RSA-PPP/ppp-2024-02-shm-pcb-altium/altium/concentrador/PCB1.step

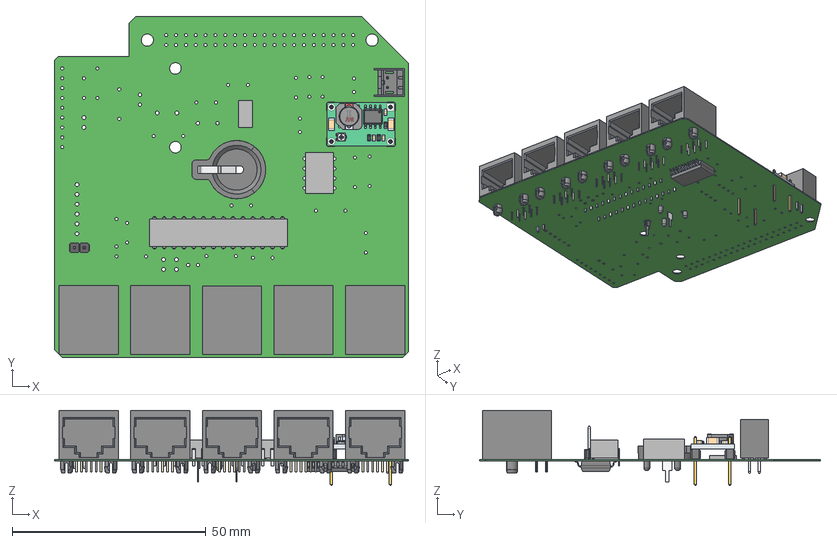
[picture p19: CAD file, 2026-11-05]
altium/concentrador/PCB1.step
91.4 x 88.0 x 19.4 mm
Board
hdr-1x2t_2.54_sh7x8
User_Library-PVZ2A_PVZ2A003
User_Library-PVZ2A_Fillet001
User_Library-so8-3
SW3DPS-CAPACITOR_0603-DEFAULT x 3
User_Library-R_SMD_0603_0603_BODY x 3
User_Library-R_SMD_0603_0603_PAD x 6
User_Library-R_SMD_0603_0603_OPIS x 3
EF8E81B4-BFF1-4722-89B6-6247B6CB4AD1 x 2
SW3DPS-HEADER_2_54_VERTICAL_2X-DEFAULT
Extruded x 87
21-0042B_20-M
rj45 x 5
