RSA-PPP/ppp-2024-02-shm-pcb-altium/altium/nodo/Librerias/acs714/STEP/SOIC-8.step

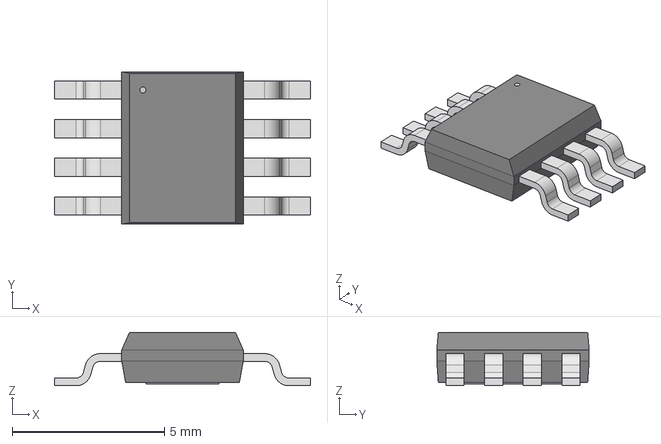
[picture p20: CAD file, 2026-11-05]
altium/nodo/Librerias/acs714/STEP/SOIC-8.step
8.40 x 5.00 x 1.75 mm
