RSA-PPP/ppp-2024-02-shm-pcb-altium/altium/nodo/Librerias/DS3231STR/STL/21-0042B_16.stp

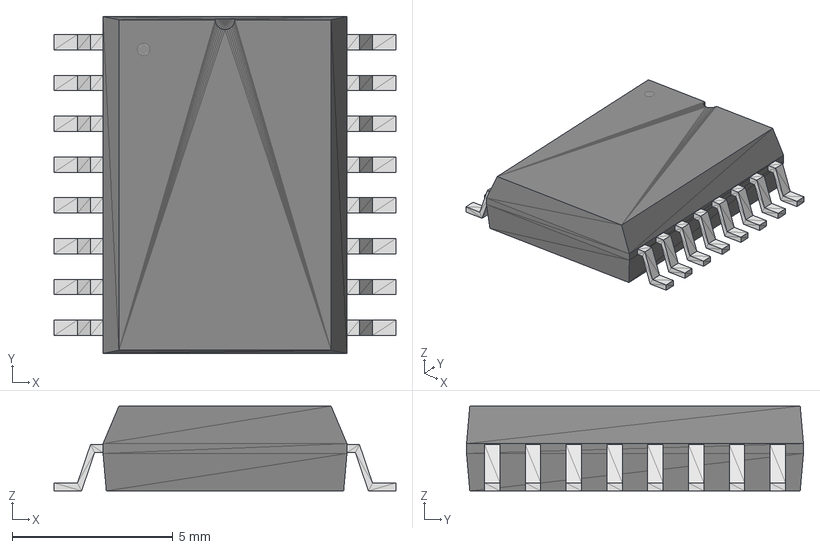
[picture p21: CAD file, 2026-11-05]
altium/nodo/Librerias/DS3231STR/STL/21-0042B_16.stp
10.6 x 10.5 x 2.64 mm
