RSA-PPP/ppp-2024-02-shm-pcb-altium/altium/nodo/Librerias/DS3234S/STEP/21-0042B_20-M.step

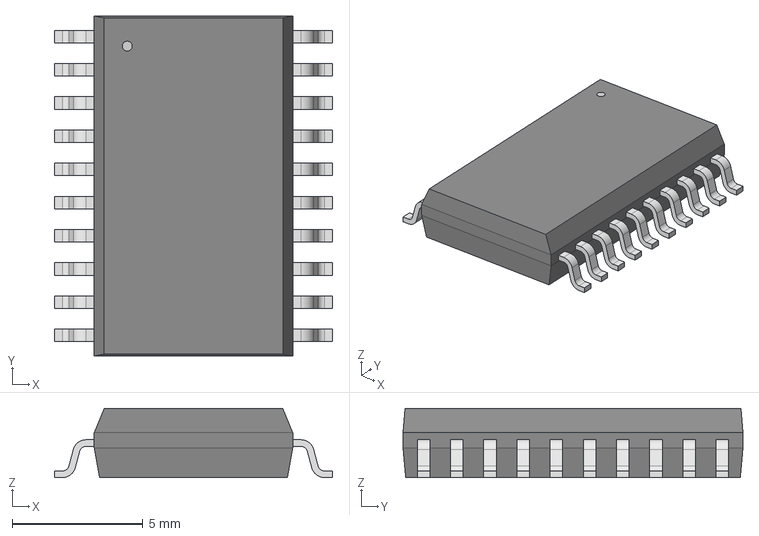
[picture p22: CAD file, 2026-11-05]
altium/nodo/Librerias/DS3234S/STEP/21-0042B_20-M.step
10.6 x 13.0 x 2.64 mm
