RSA-PPP/ppp-2024-02-shm-pcb-altium/altium/nodo/Librerias/HEF4071BP/STEP/SOT27-1.step

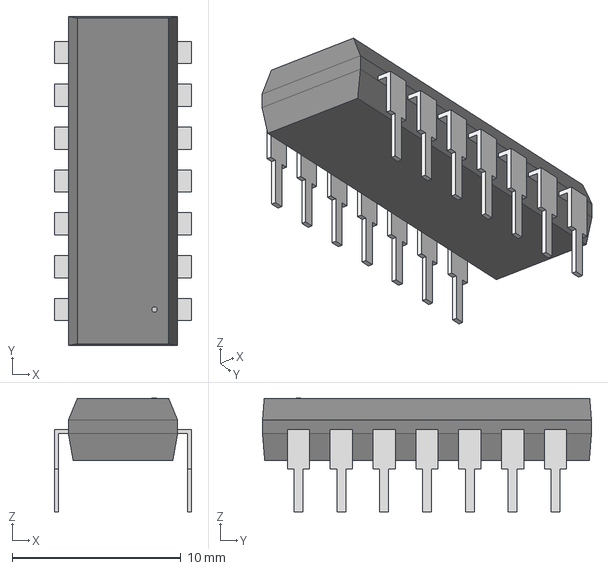
[picture p23: CAD file, 2026-11-05]
altium/nodo/Librerias/HEF4071BP/STEP/SOT27-1.step
8.13 x 19.5 x 6.73 mm
