RSA-PPP/ppp-2024-02-shm-pcb-altium/altium/nodo/Librerias/digiKey/LM1117DT_5_0_NOPB/LM1117DT-5.0_NOPB.step

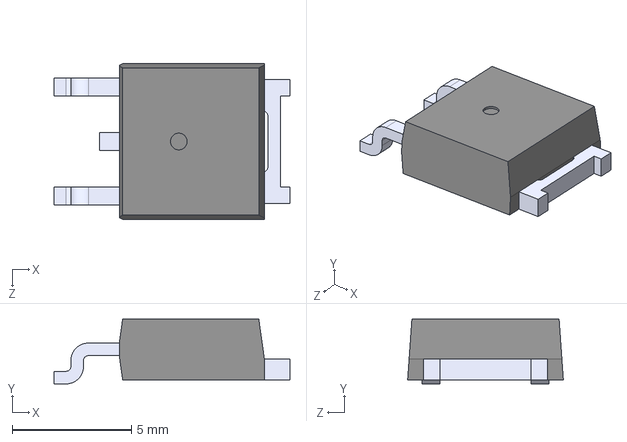
[picture p24: CAD file, 2026-11-05]
altium/nodo/Librerias/digiKey/LM1117DT_5_0_NOPB/LM1117DT-5.0_NOPB.step
9.91 x 2.72 x 6.54 mm
