RSA-PPP/ppp-2024-02-shm-pcb-altium/(list of files, cad)

Other CAD files:
altium/nodo/cortes acrilico 5MM.dwg
docs/hardware/cortes acrilico 5MM.dwg
altium/nodo/Librerias/DS3231STR/STL/21-0042B_16-L.stp
altium/nodo/Librerias/DS3234S/STEP/21-0042B_20-L.step
altium/nodo/PCB.DWG
docs/hardware/PCB.DWG
altium/nodo/Librerias/DS3231STR/STL/21-0042B_16-M.stp
altium/nodo/Librerias/DS3234S/STEP/21-0042B_20.step
altium/nodo/Librerias/DS3231STR/STL/21-0042B_16-L.stl
altium/nodo/Librerias/DS3231STR/STL/21-0042B_16-M.stl
altium/nodo/Librerias/DS3231STR/STL/21-0042B_16.stl
