RSA-PPP/ppp-2024-02-shm-pcb-altium/altium/concentrador/Sheet1.pdf

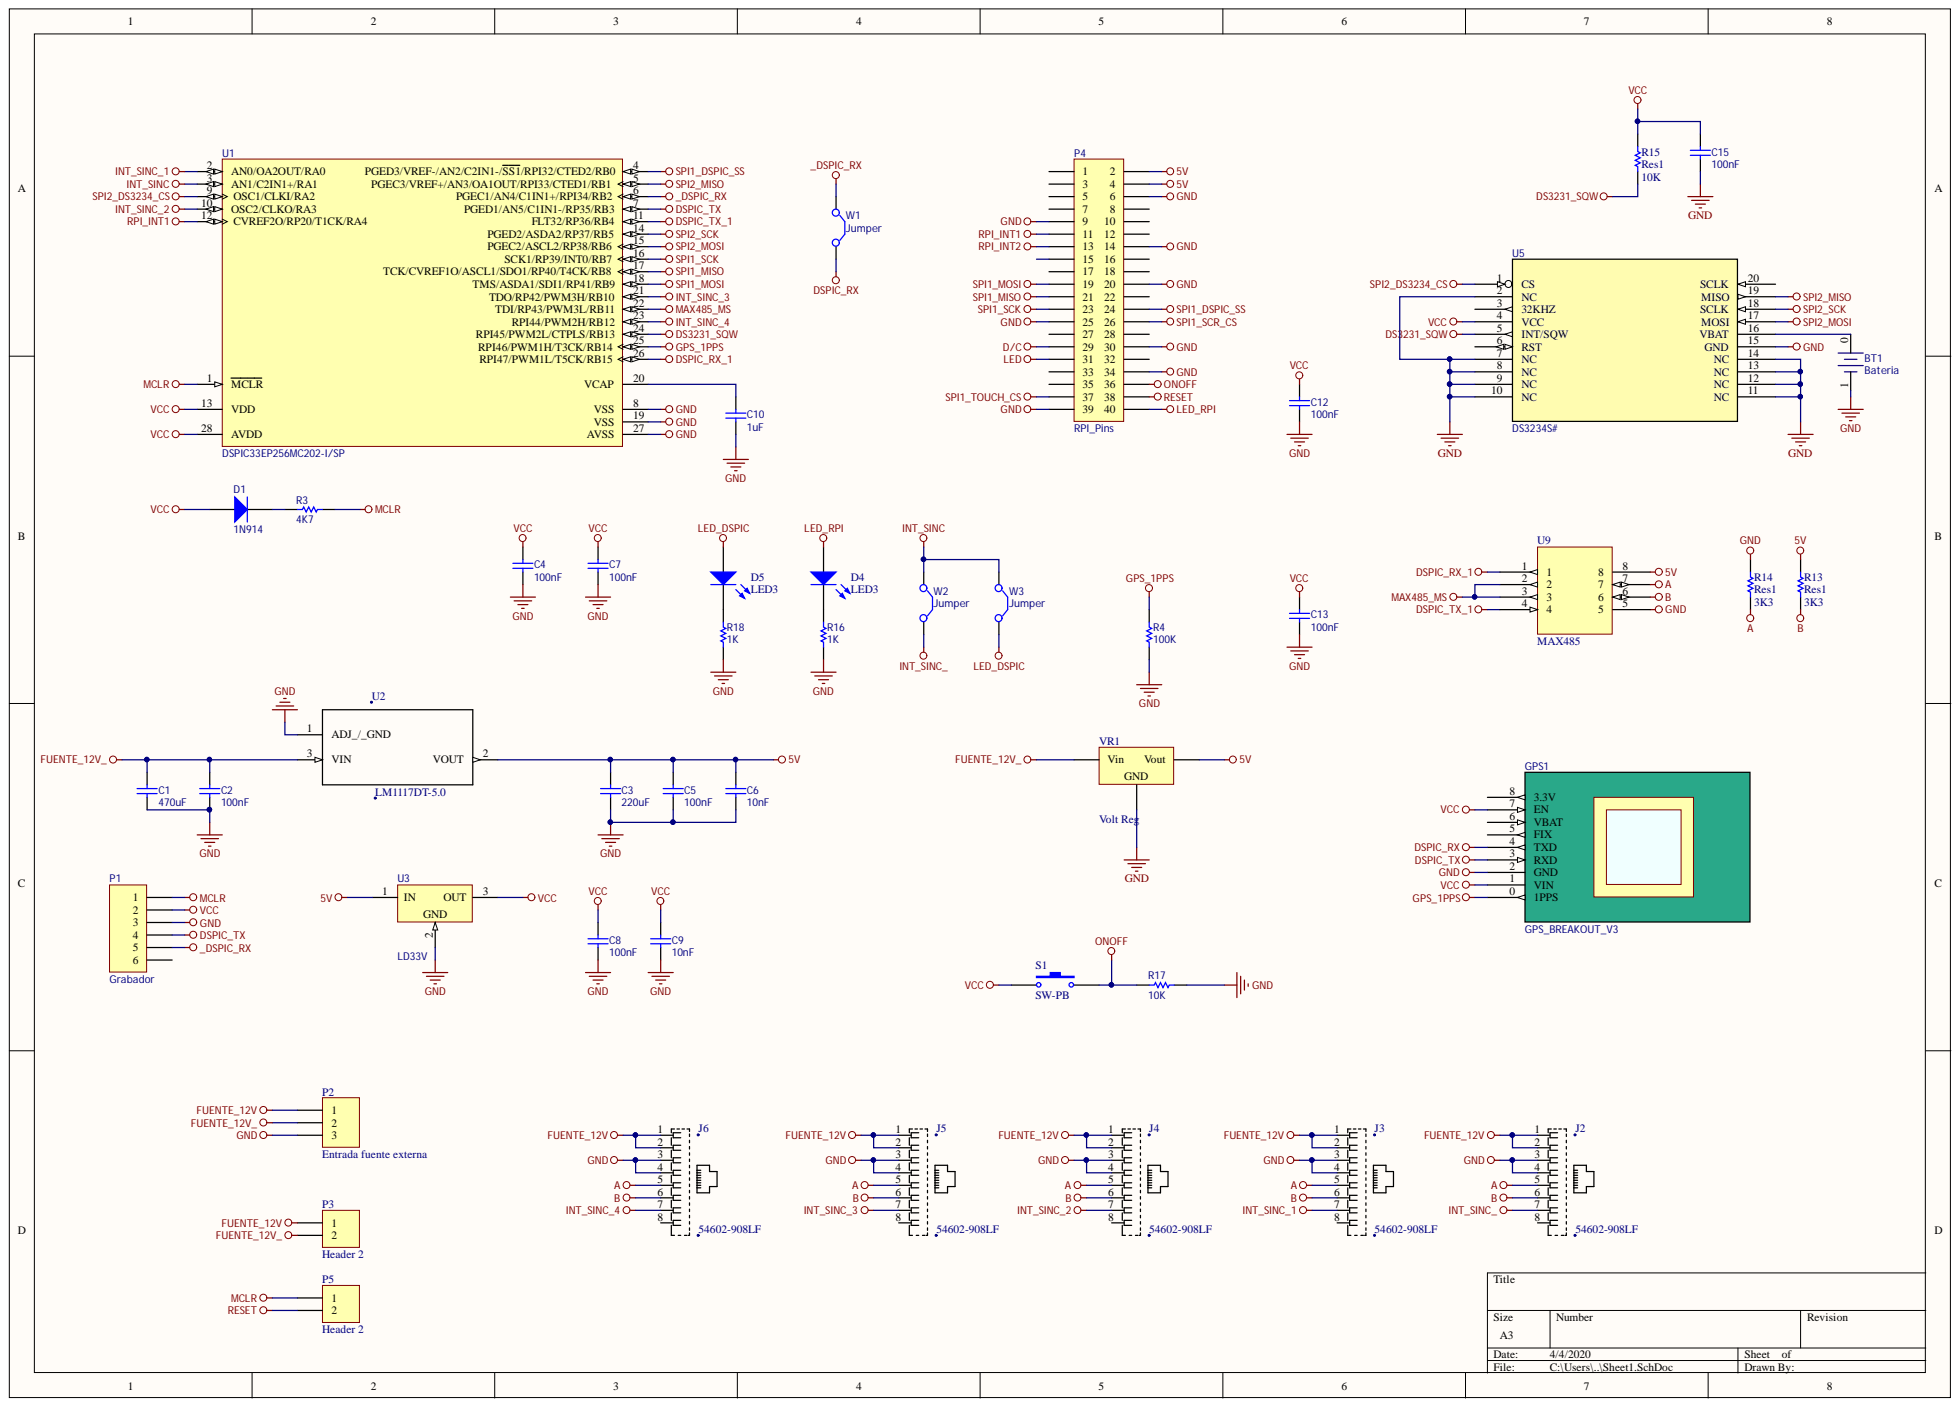
[picture p25: page 1]

Comment | Description | Designator | Footprint | LibRef | Quantity
Bateria | | BT1 | Bateria-DS1307 | BateriaDS1307 | 1
Cap | Capacitor | C1, C3 | C100UFB | Cap | 2
Cap | Capacitor | C2, C4, C5, C6, C7, C8, C9, C10, C12, C13, C15 | RAD0.2 | Cap | 11
1N914 | High Conductance Fast Diode | D1 | DO-35 | Diode 1N914 | 1
LED3 | Typical BLUE SiC LED | D4, D5 | LED2 | LED3 | 2
GPS_BREAKOUT_V3 | | GPS1 | GPS_BREAKOUT_V3 | GPS_BREAKOUT_V3 | 1
54602-908LF | Jack Modular Connector 8p8c _RJ45, Ethernet_ 90Â° Angle _Right_ Unshielded Cat3 | J2, J3, J4, J5, J6 | *AMPHENOL_54602-908LF | 54602-908LF | 5
Grabador | Header, 6-Pin | P1 | HDR1X6 | Header 6 | 1
Entrada fuente externa | Header, 3-Pin | P2 | MOLEX-3 | Header 3 | 1
Header 2 | Header, 2-Pin | P3, P5 | Header 1X2 | Header 2 | 2
RPI_Pins | Header, 20-Pin, Dual row | P4 | HDR2X20 | Header 20X2 | 1
Res1 | Resistor | R3, R4, R13, R14, R15, R16, R17, R18 | AXIAL-0.3 | Res1 | 8
SW-PB | Switch | S1 | PULSA4 | SW-PB | 1
DSPIC33EP256MC202-I/SP | 16-Bit Microcontroller and Digital Signal Controller with High-Speed PWM, Op Amps and Advanced Analog, 70 MIPS, 21 I/O, GPIO, -40 to 85 degC, 28-pin SPDIP (SP28), Tube | U1 | MCHP-SPDIP-SP28 | DSPIC33EP256MC202-I/SP | 1
LM1117DT-5.0 | Linear Voltage Regulator IC 1 Output 800mA TO-252-3 | U2 | *TO228P970X238-3N | LM1117DT-5.0 | 1
LD33V | High-Performance 16-bit Digital Signal Controller, 24 KB Flash, 2 KB SRAM, 1 KB EEPROM, 40-Pin PDIP, Industrial Temperature | U3 | SOT-223 | LD33V | 1
DS3234S# | No Description Available | U5 | 21-0042B_20 | DS3234S# | 1
MAX485 | | U9 | MAX485 | MAX485 | 1
Volt Reg | Voltage Regulator | VR1 | TO-220V | Volt Reg | 1
Jumper | Jumper Wire | W1, W2, W3 | SIP-2 | Jumper | 3
