RSA-PPP/ppp-2024-02-shm-pcb-altium/docs/hardware/acelerografo(NoDo).pdf

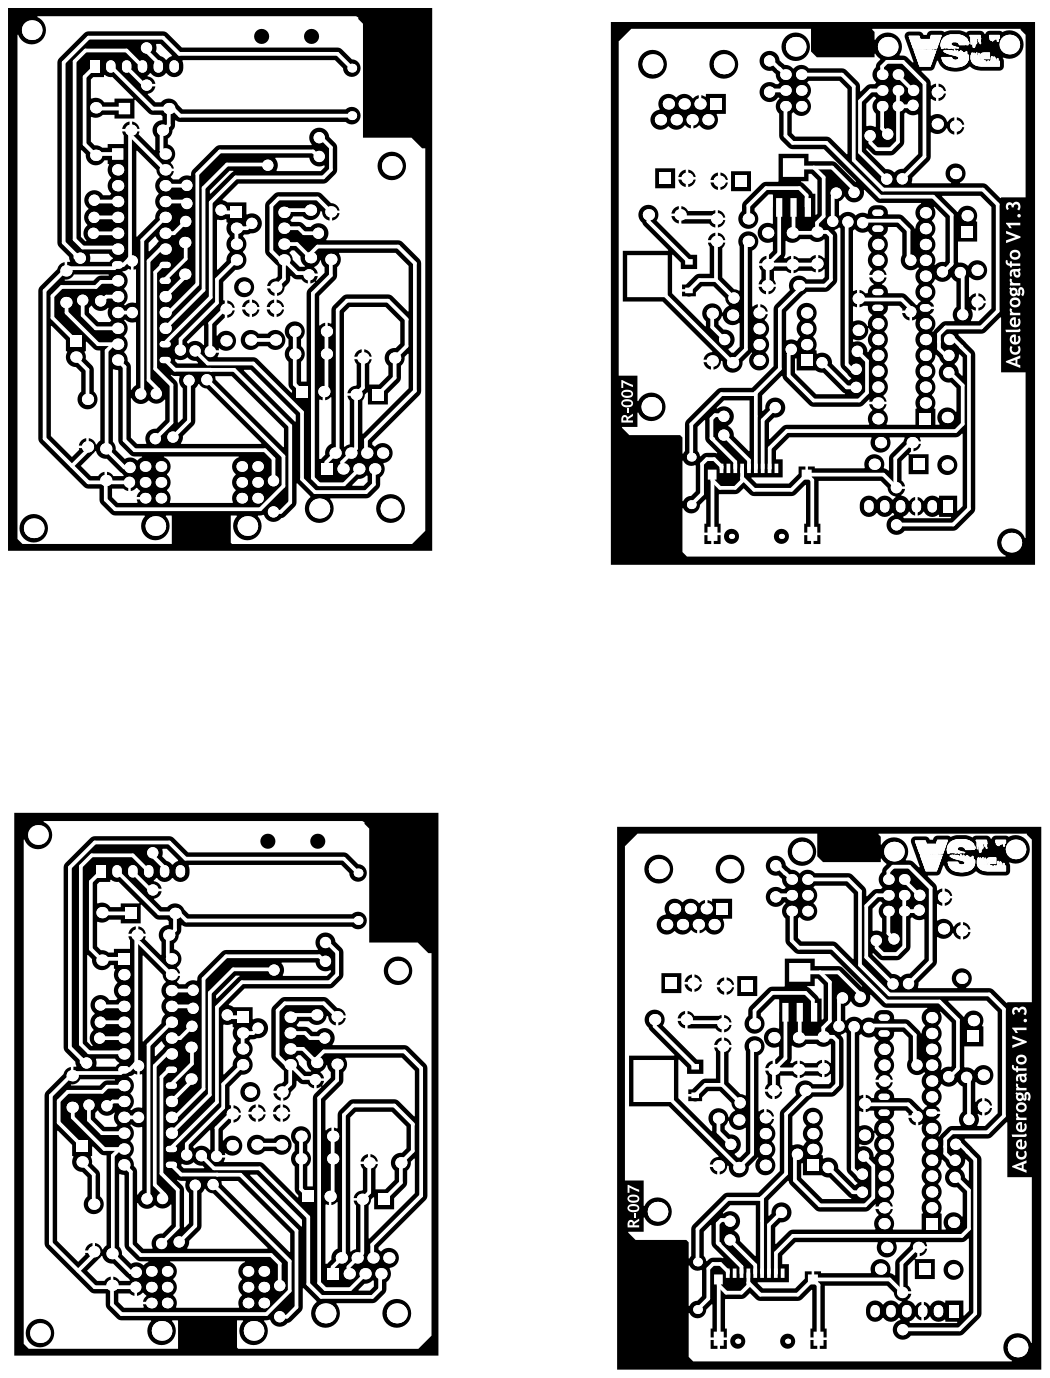
[picture p26: page 1]
