RSA-PPP/ppp-2024-02-shm-pcb-altium/docs/hardware/acelerometro_concetrador.pdf

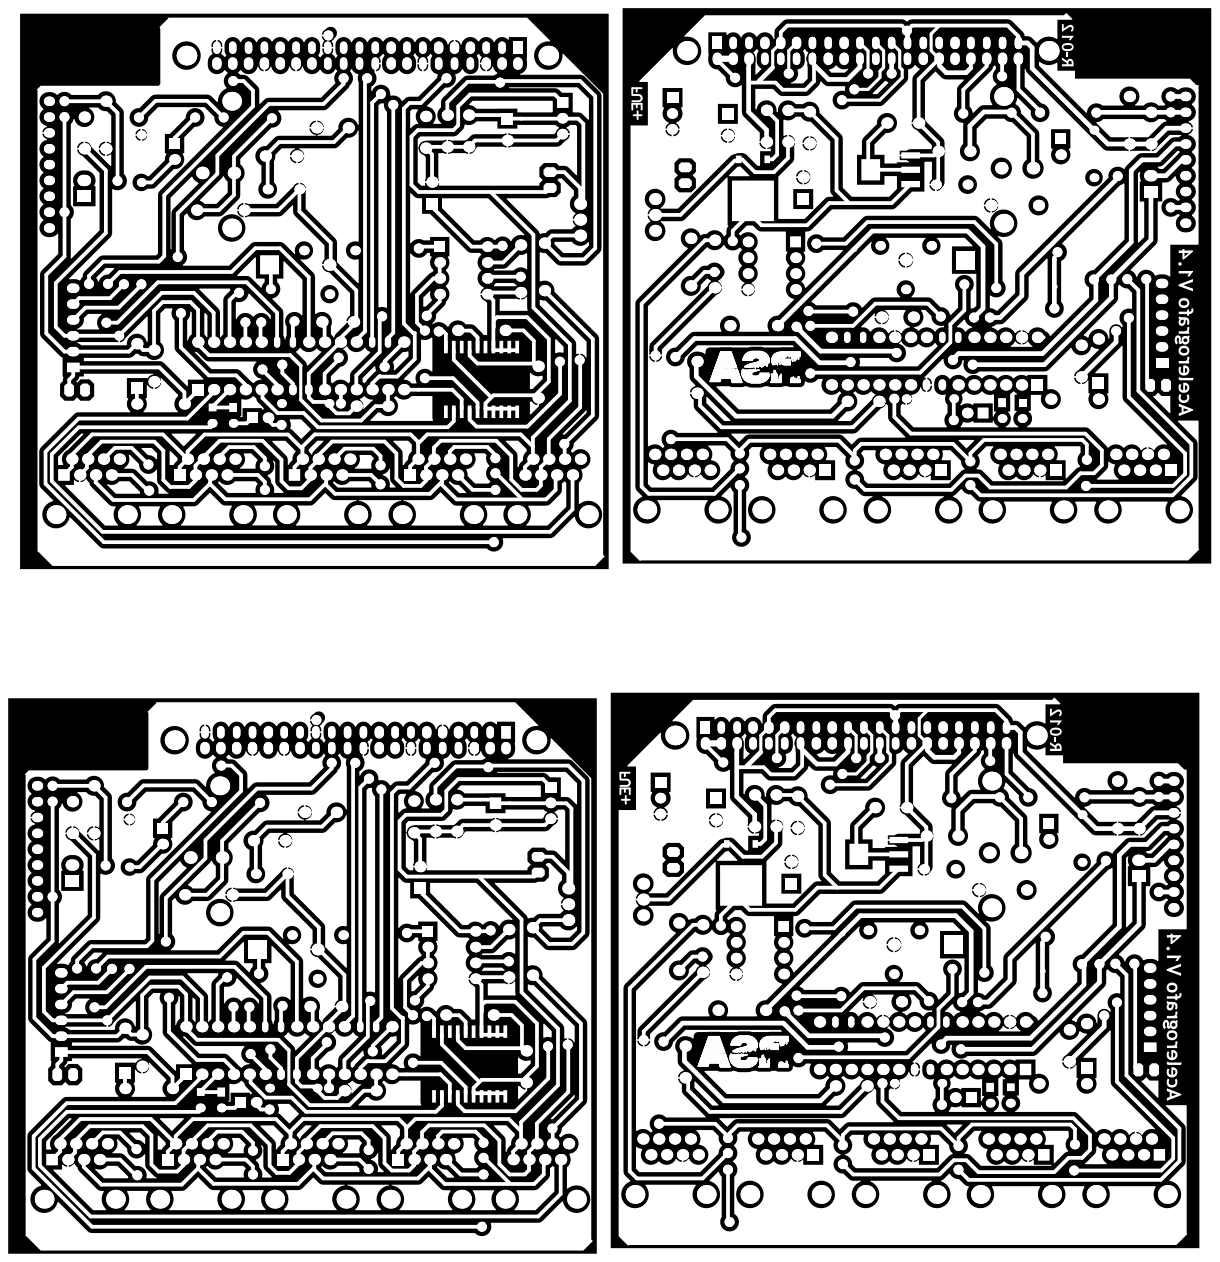
[picture p27: page 1]
