RSA-PPP/ppp-2024-02-shm-pcb-altium/docs/hardware/acelerometro_nodo.pdf

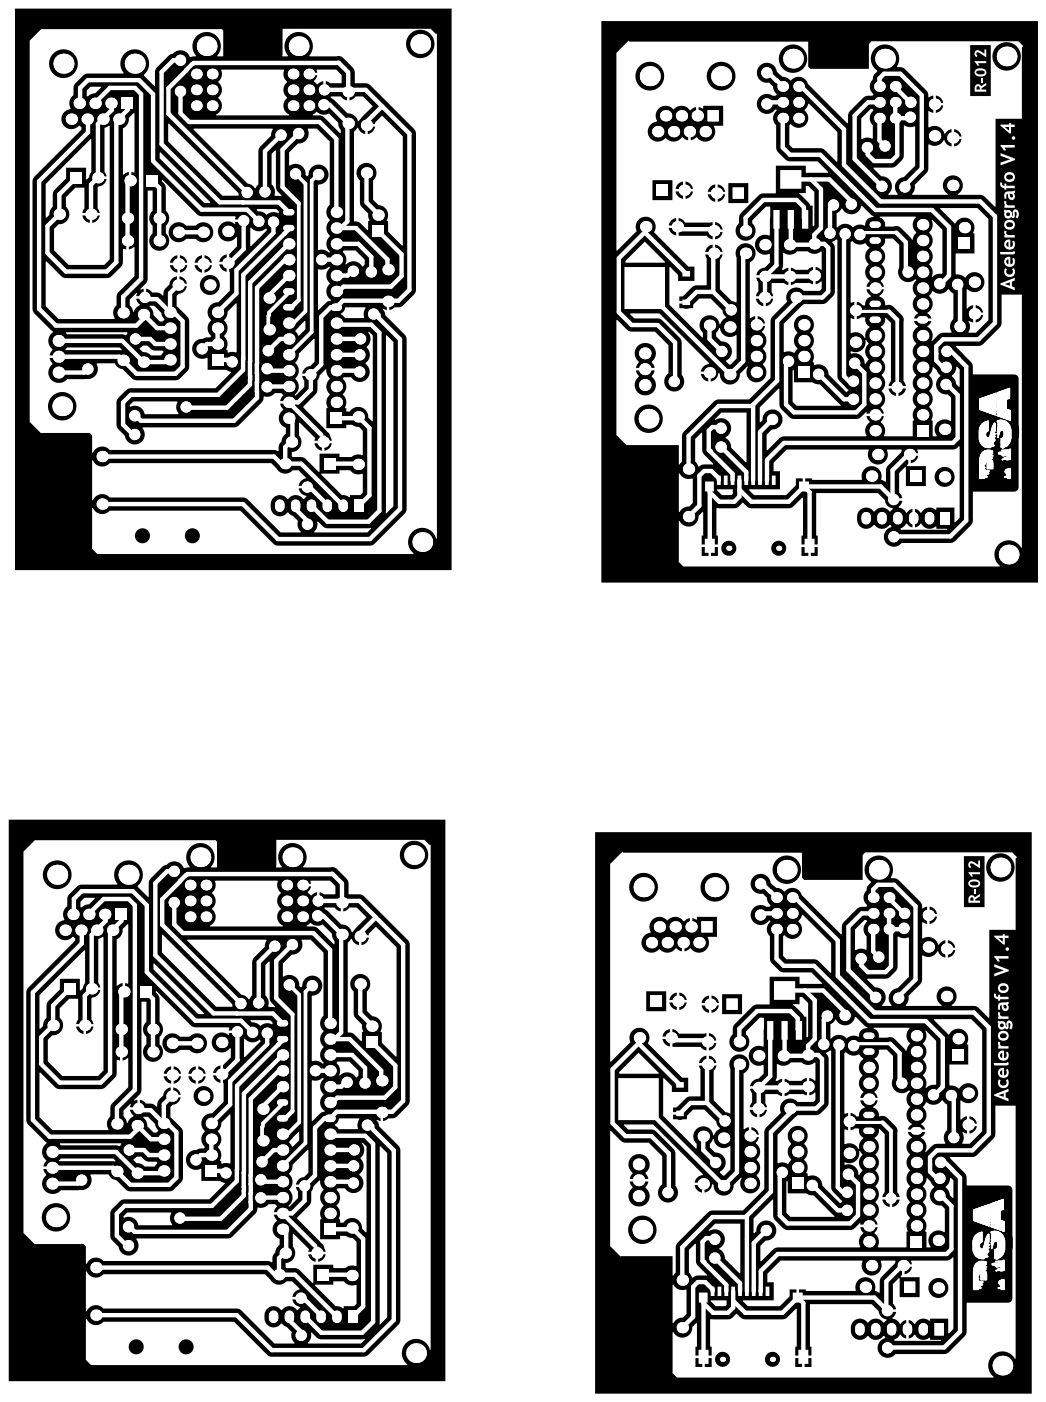
[picture p28: page 1]
