RSA-PPP/ppp-2024-02-shm-pcb-altium/docs/hardware/Esquematico_PCB_Concentrador.pdf

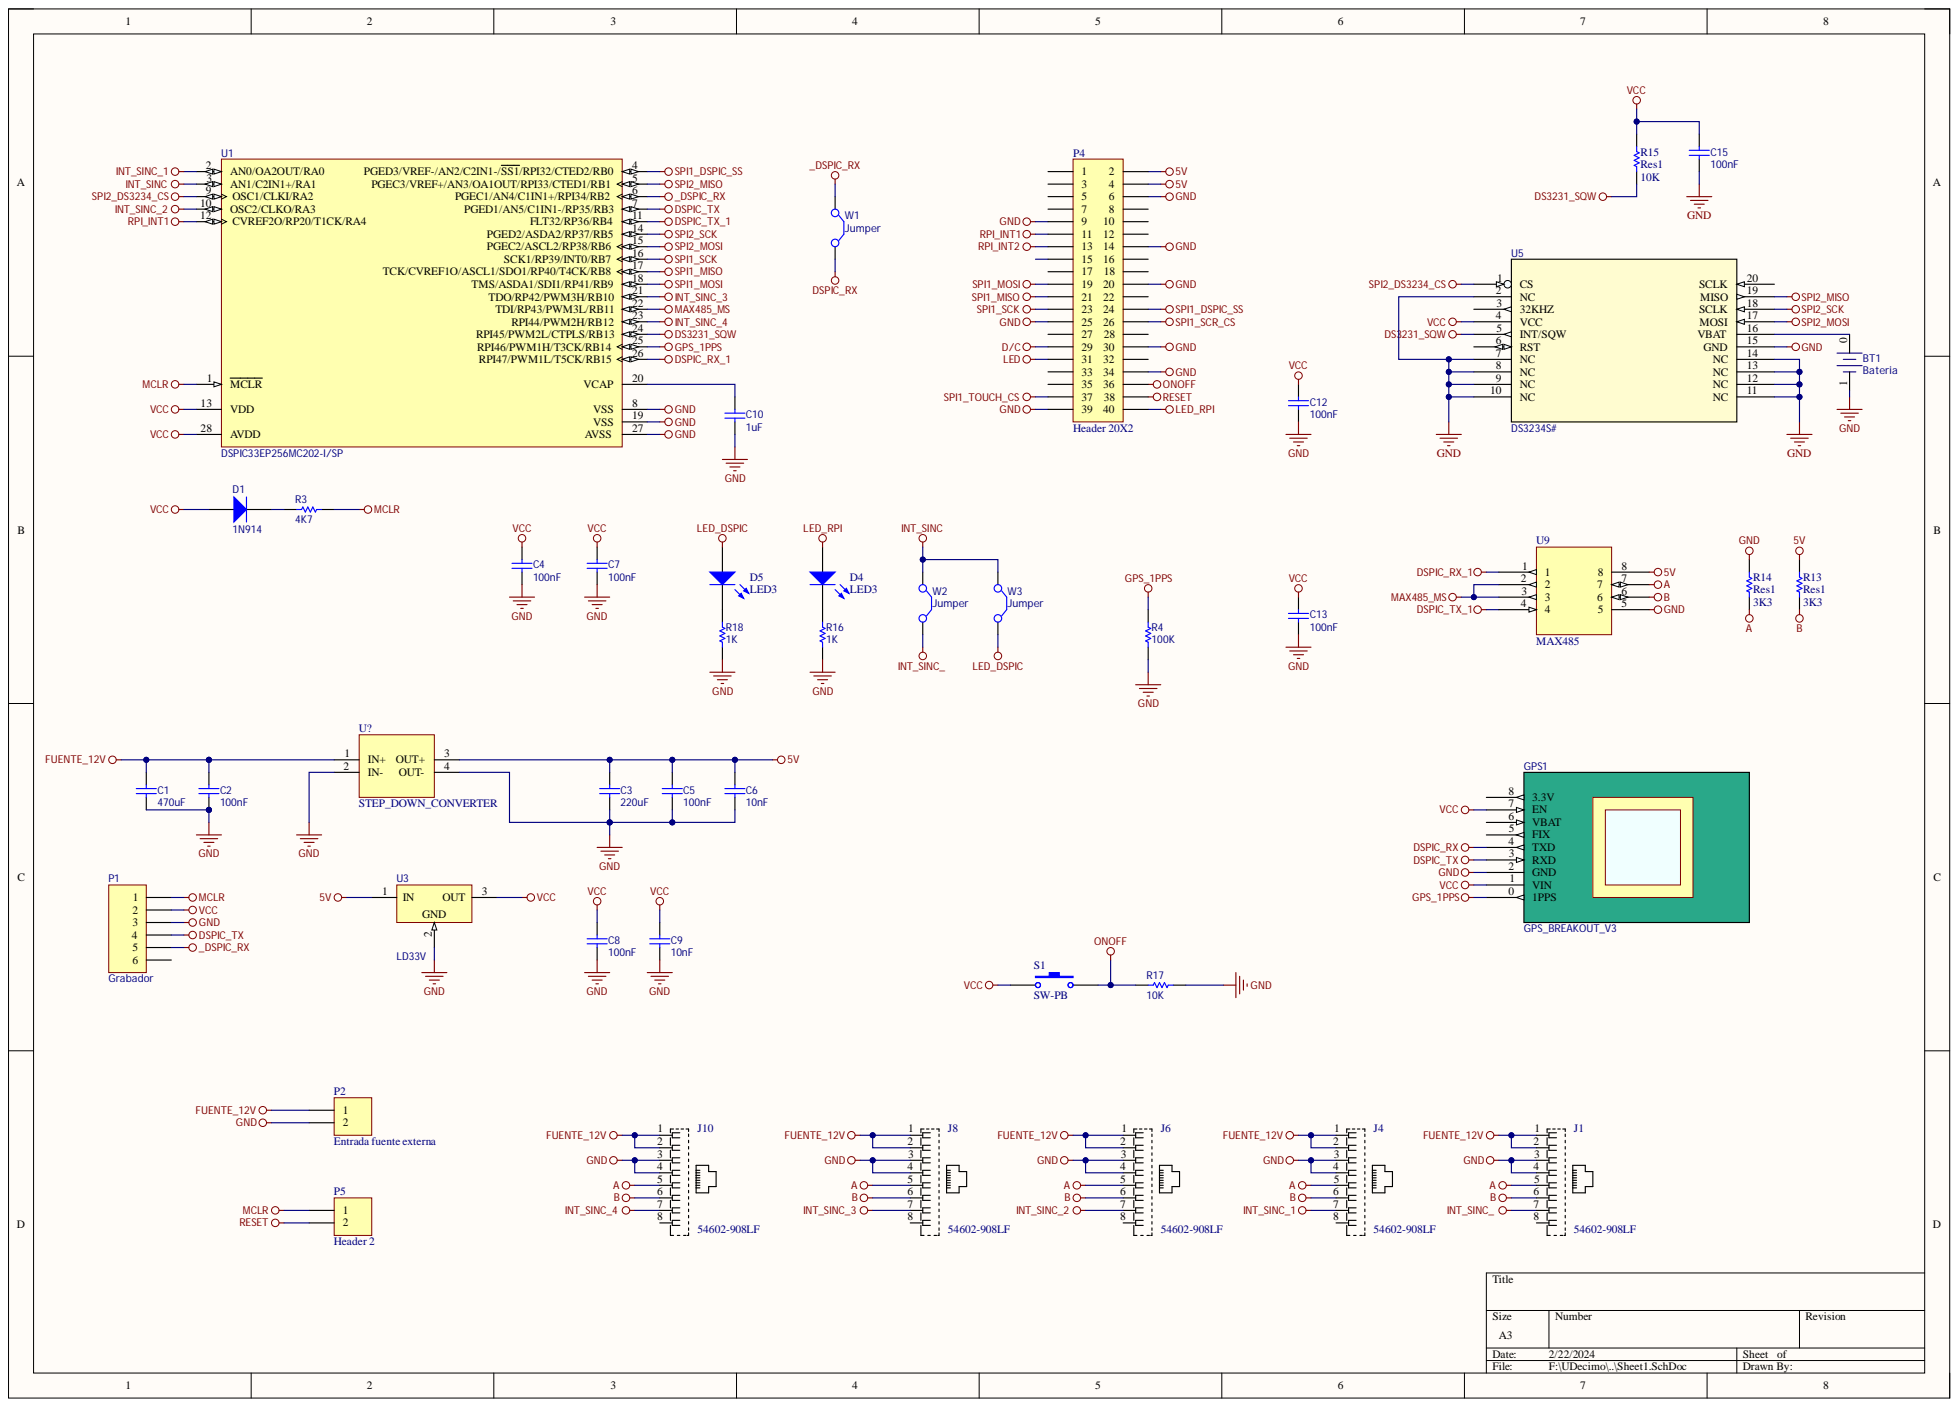
[picture p29: page 1]

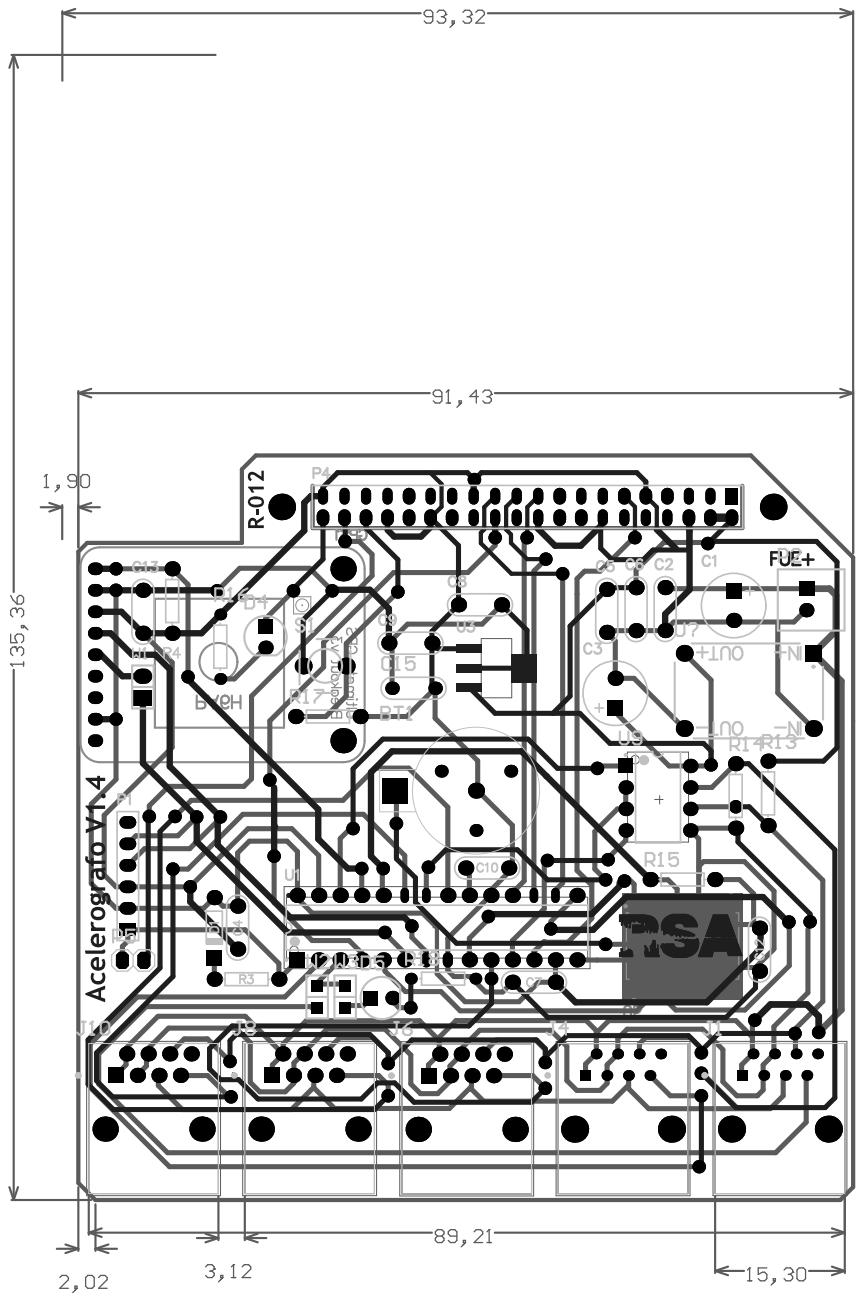
[picture p30: page 2]
