RSA-PPP/ppp-2024-02-shm-pcb-altium/docs/hardware/Fotolito.pdf

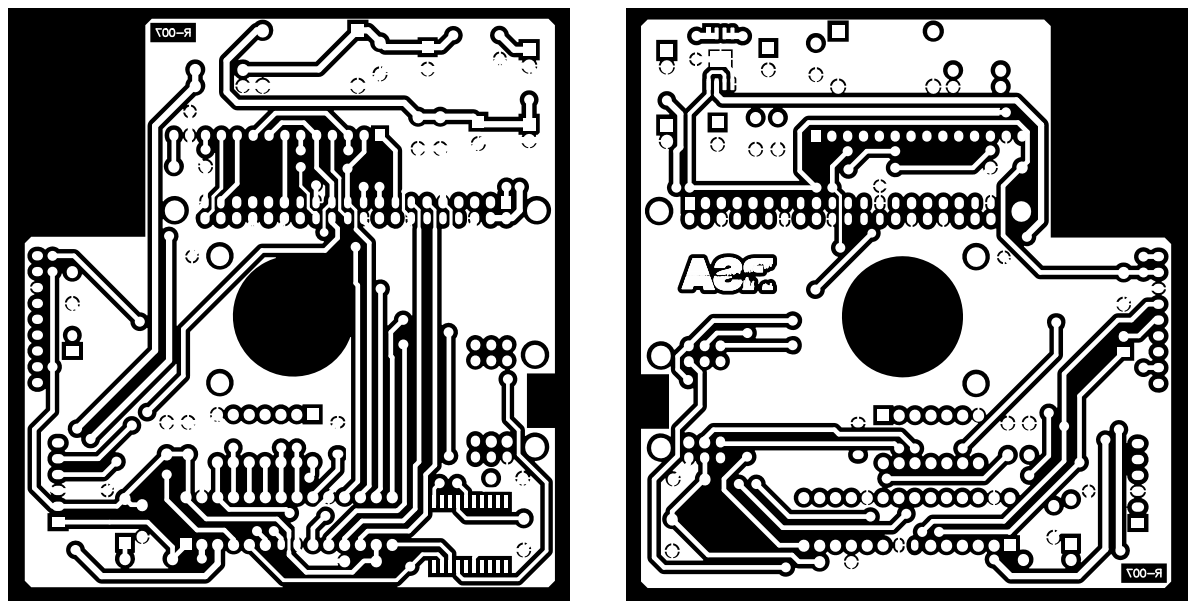
[picture p31: page 1]
