RSA-PPP/ppp-2024-02-shm-pcb-altium/docs/hardware/fotolitoBOTTOM.pdf

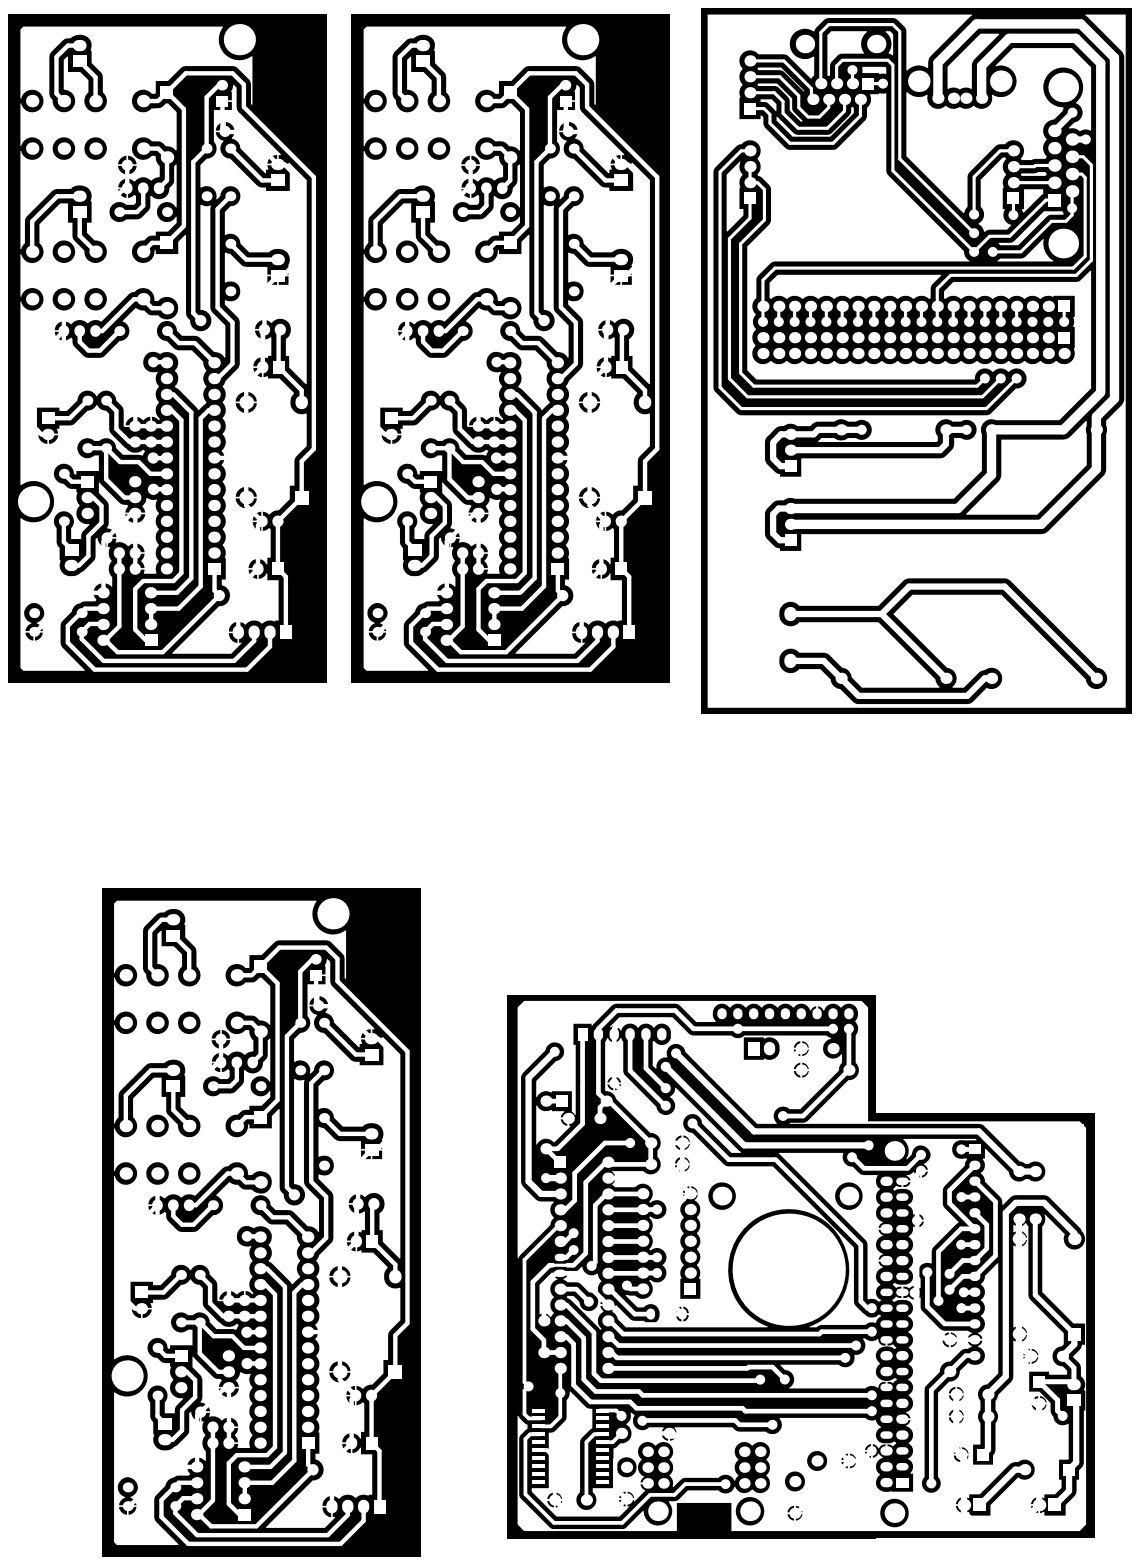
[picture p32: page 1]
