RSA-PPP/ppp-2024-02-shm-pcb-altium/docs/hardware/fotolitoTOP.pdf

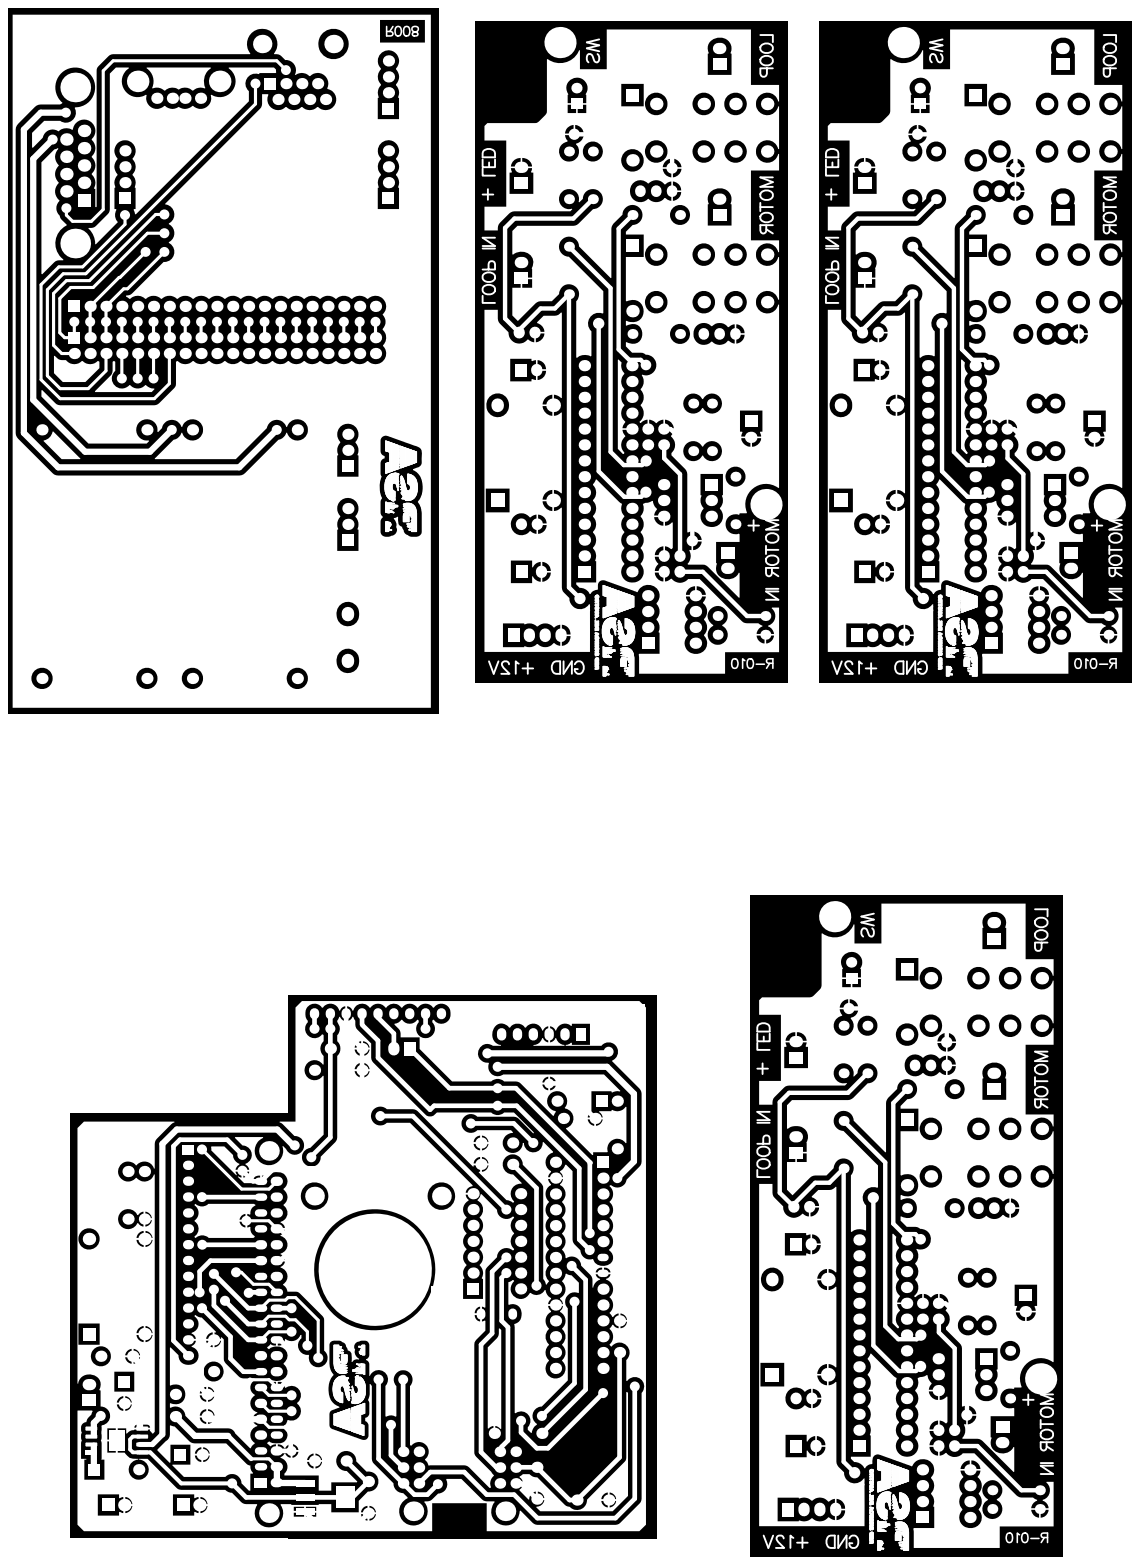
[picture p33: page 1]
