RSA-PPP/ppp-2024-02-shm-pcb-altium/docs/hardware/Job1_Concentrador.PDF

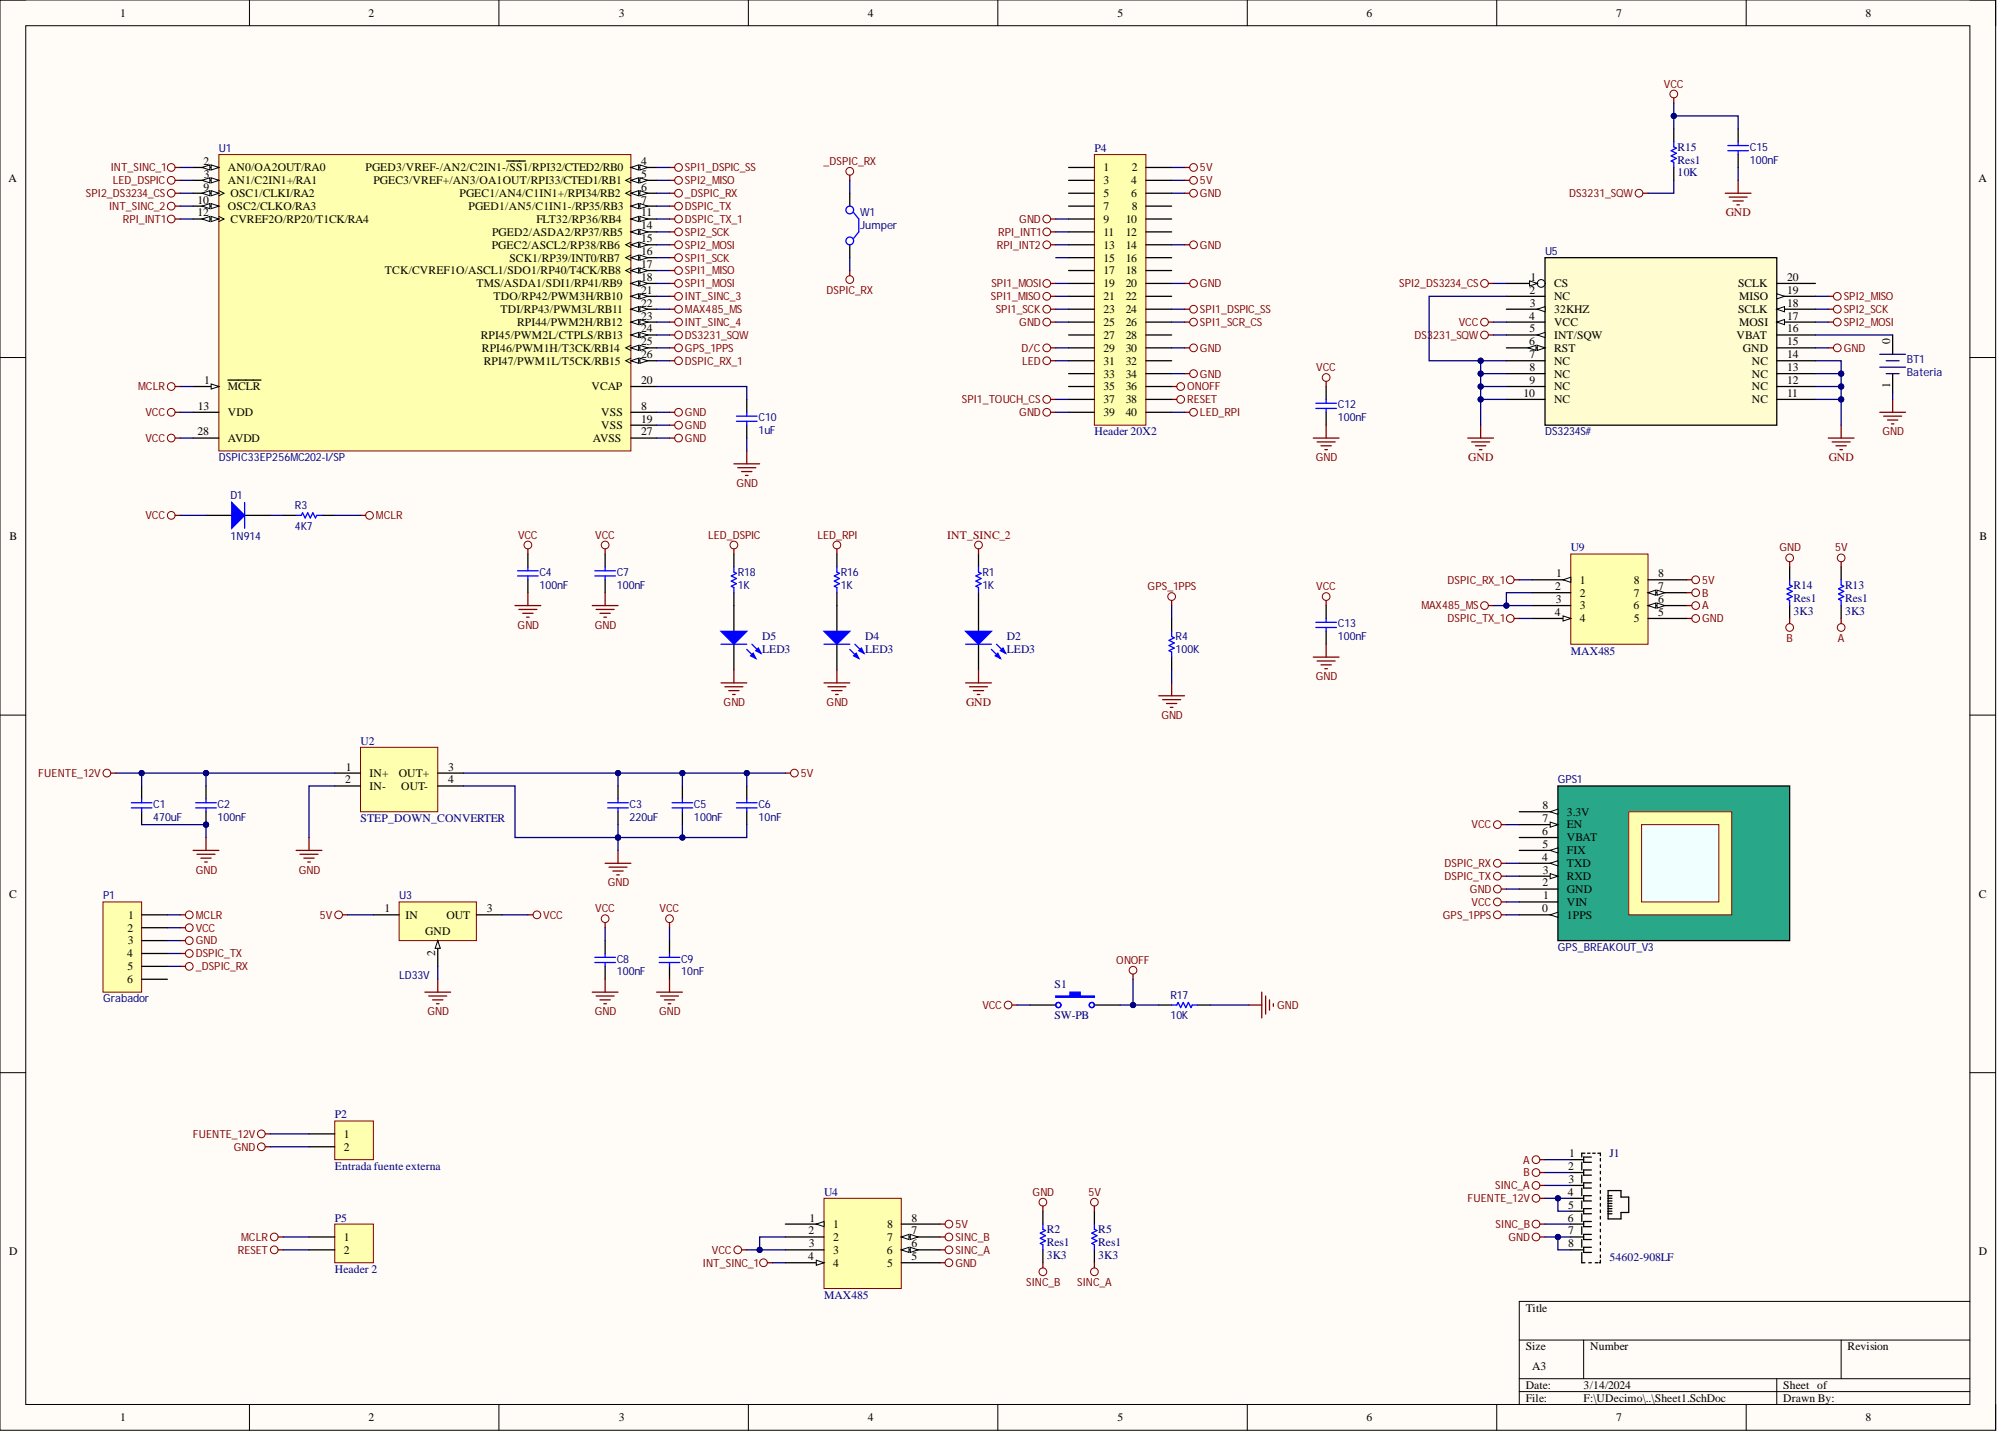
[picture p34: page 1]

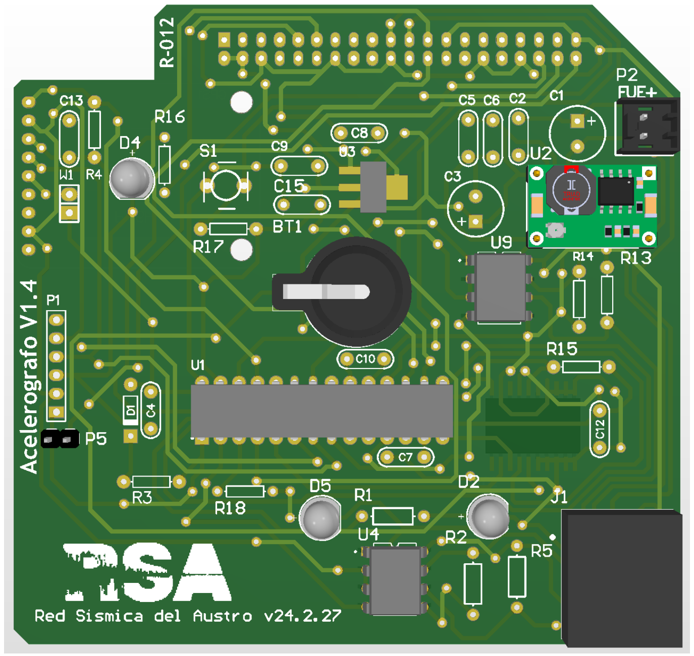
[picture p35: page 2]

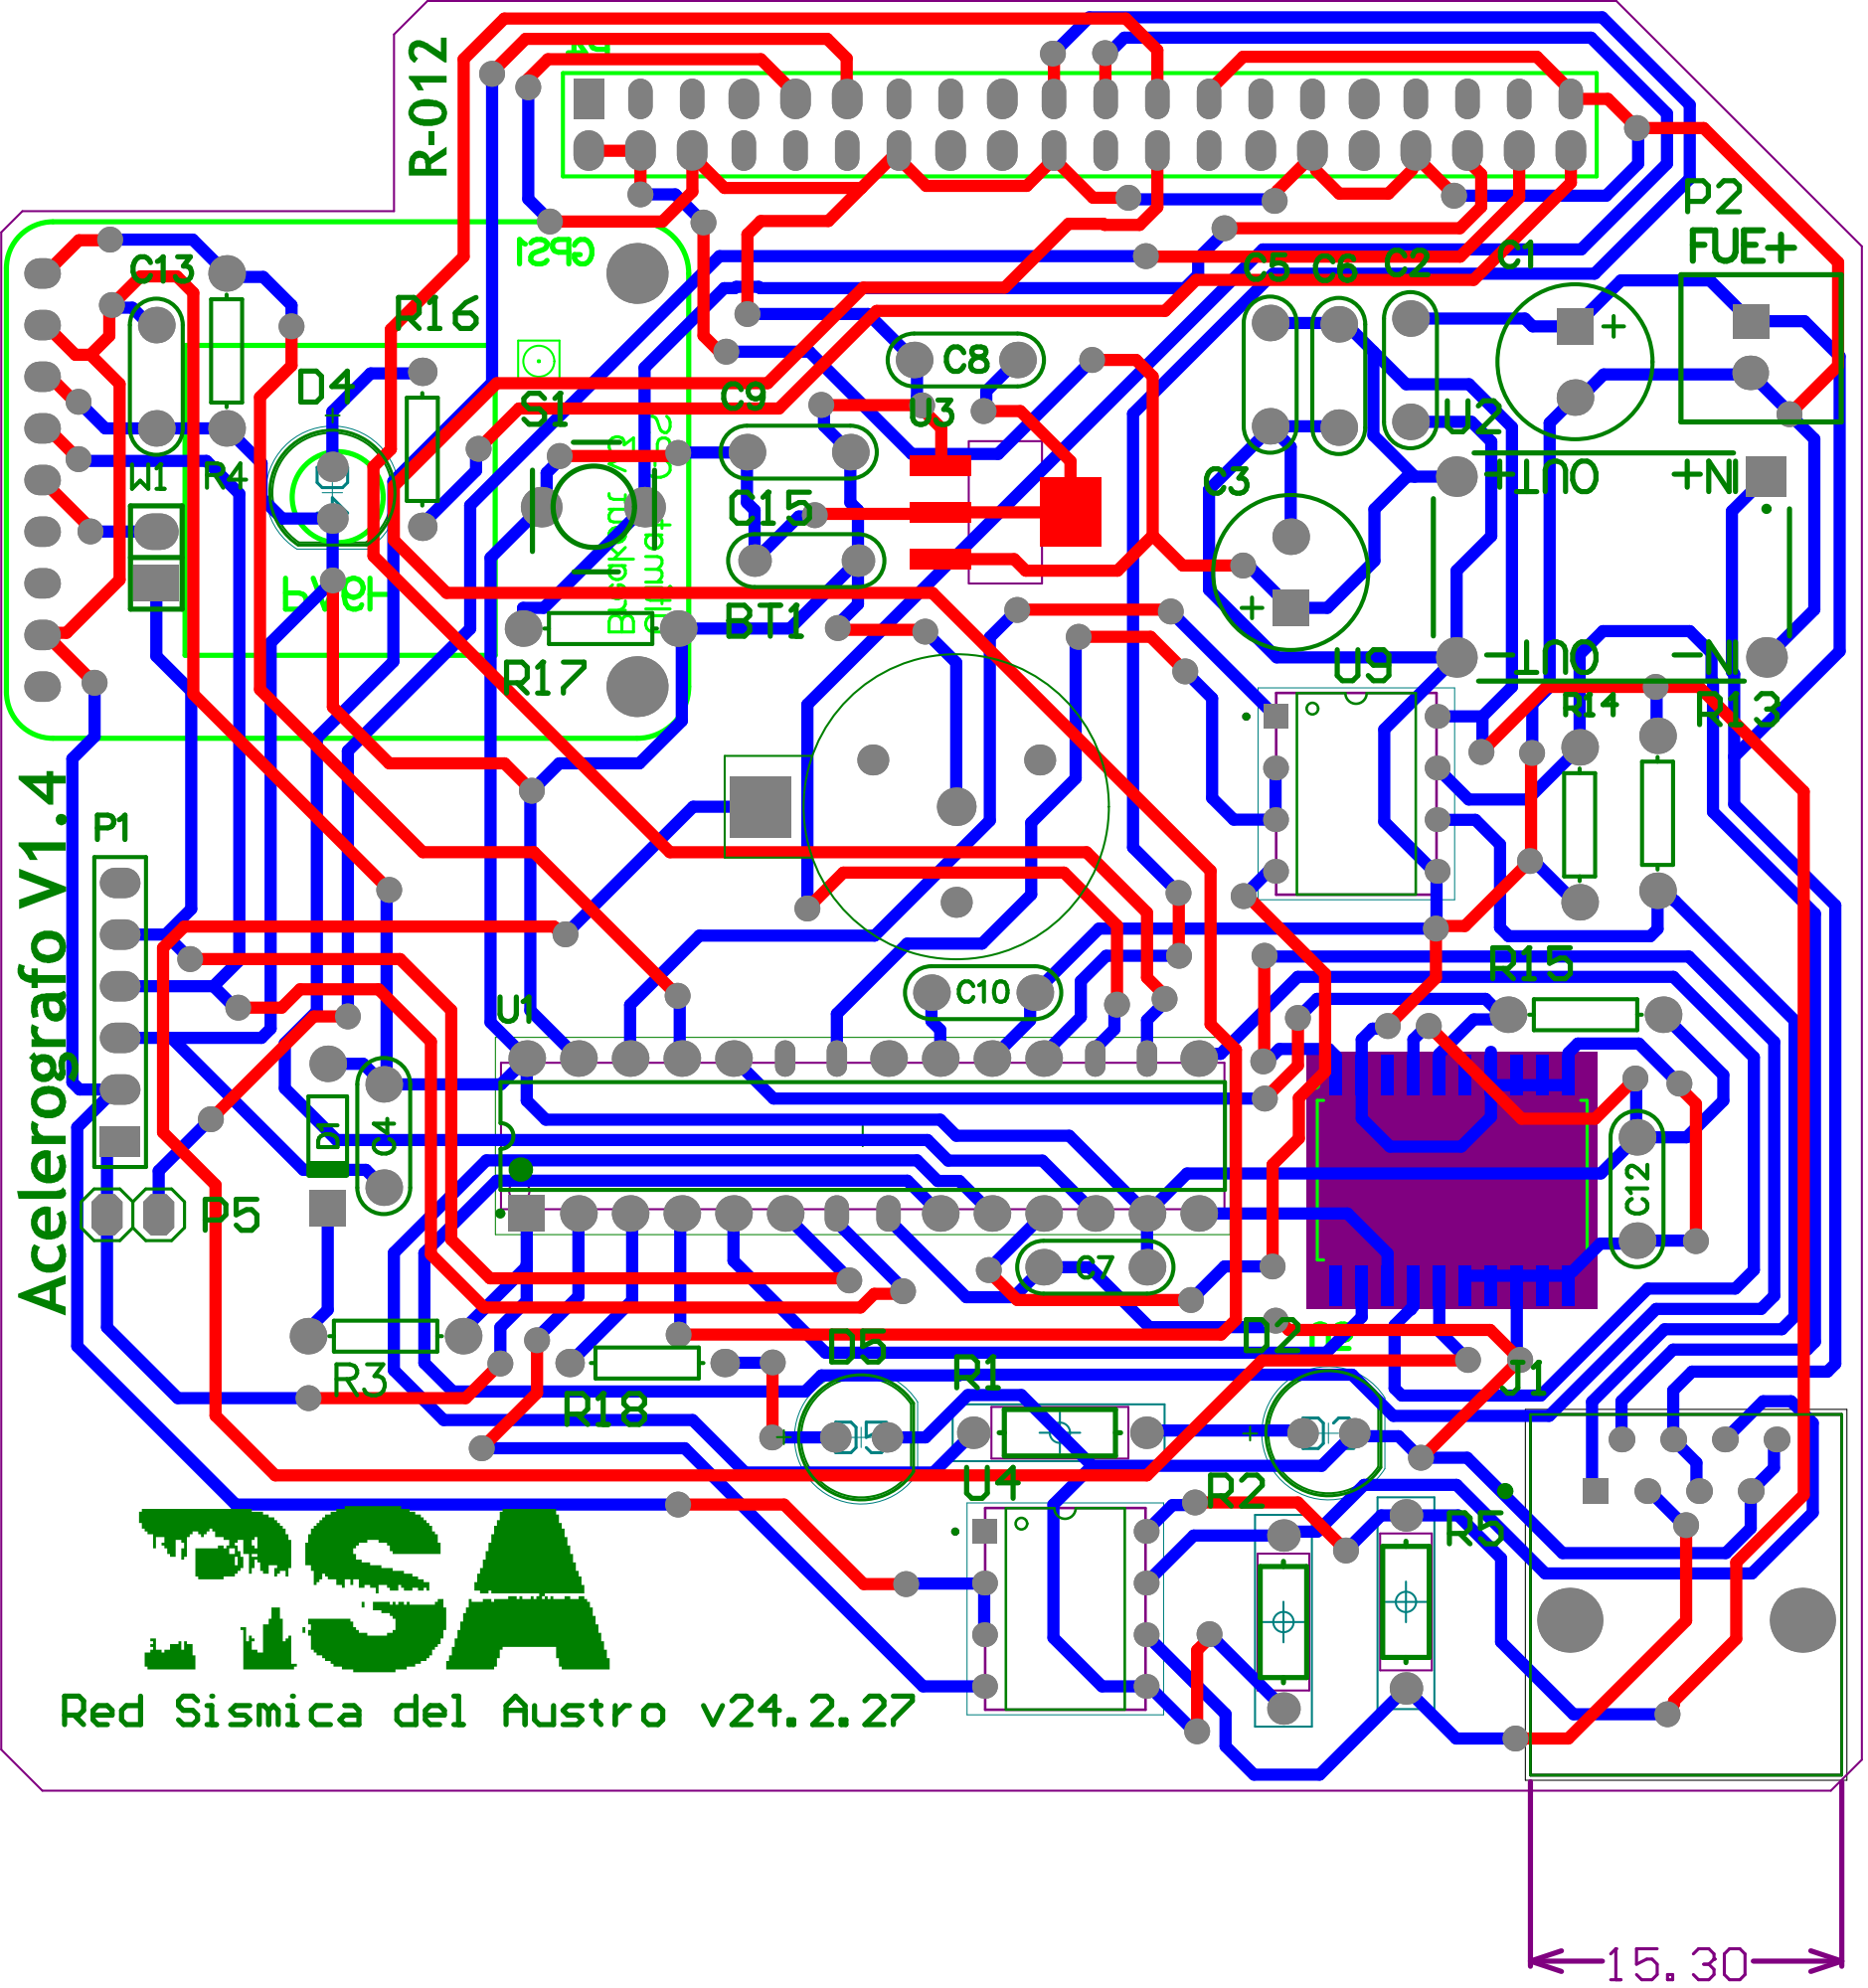
[picture p36: page 3]

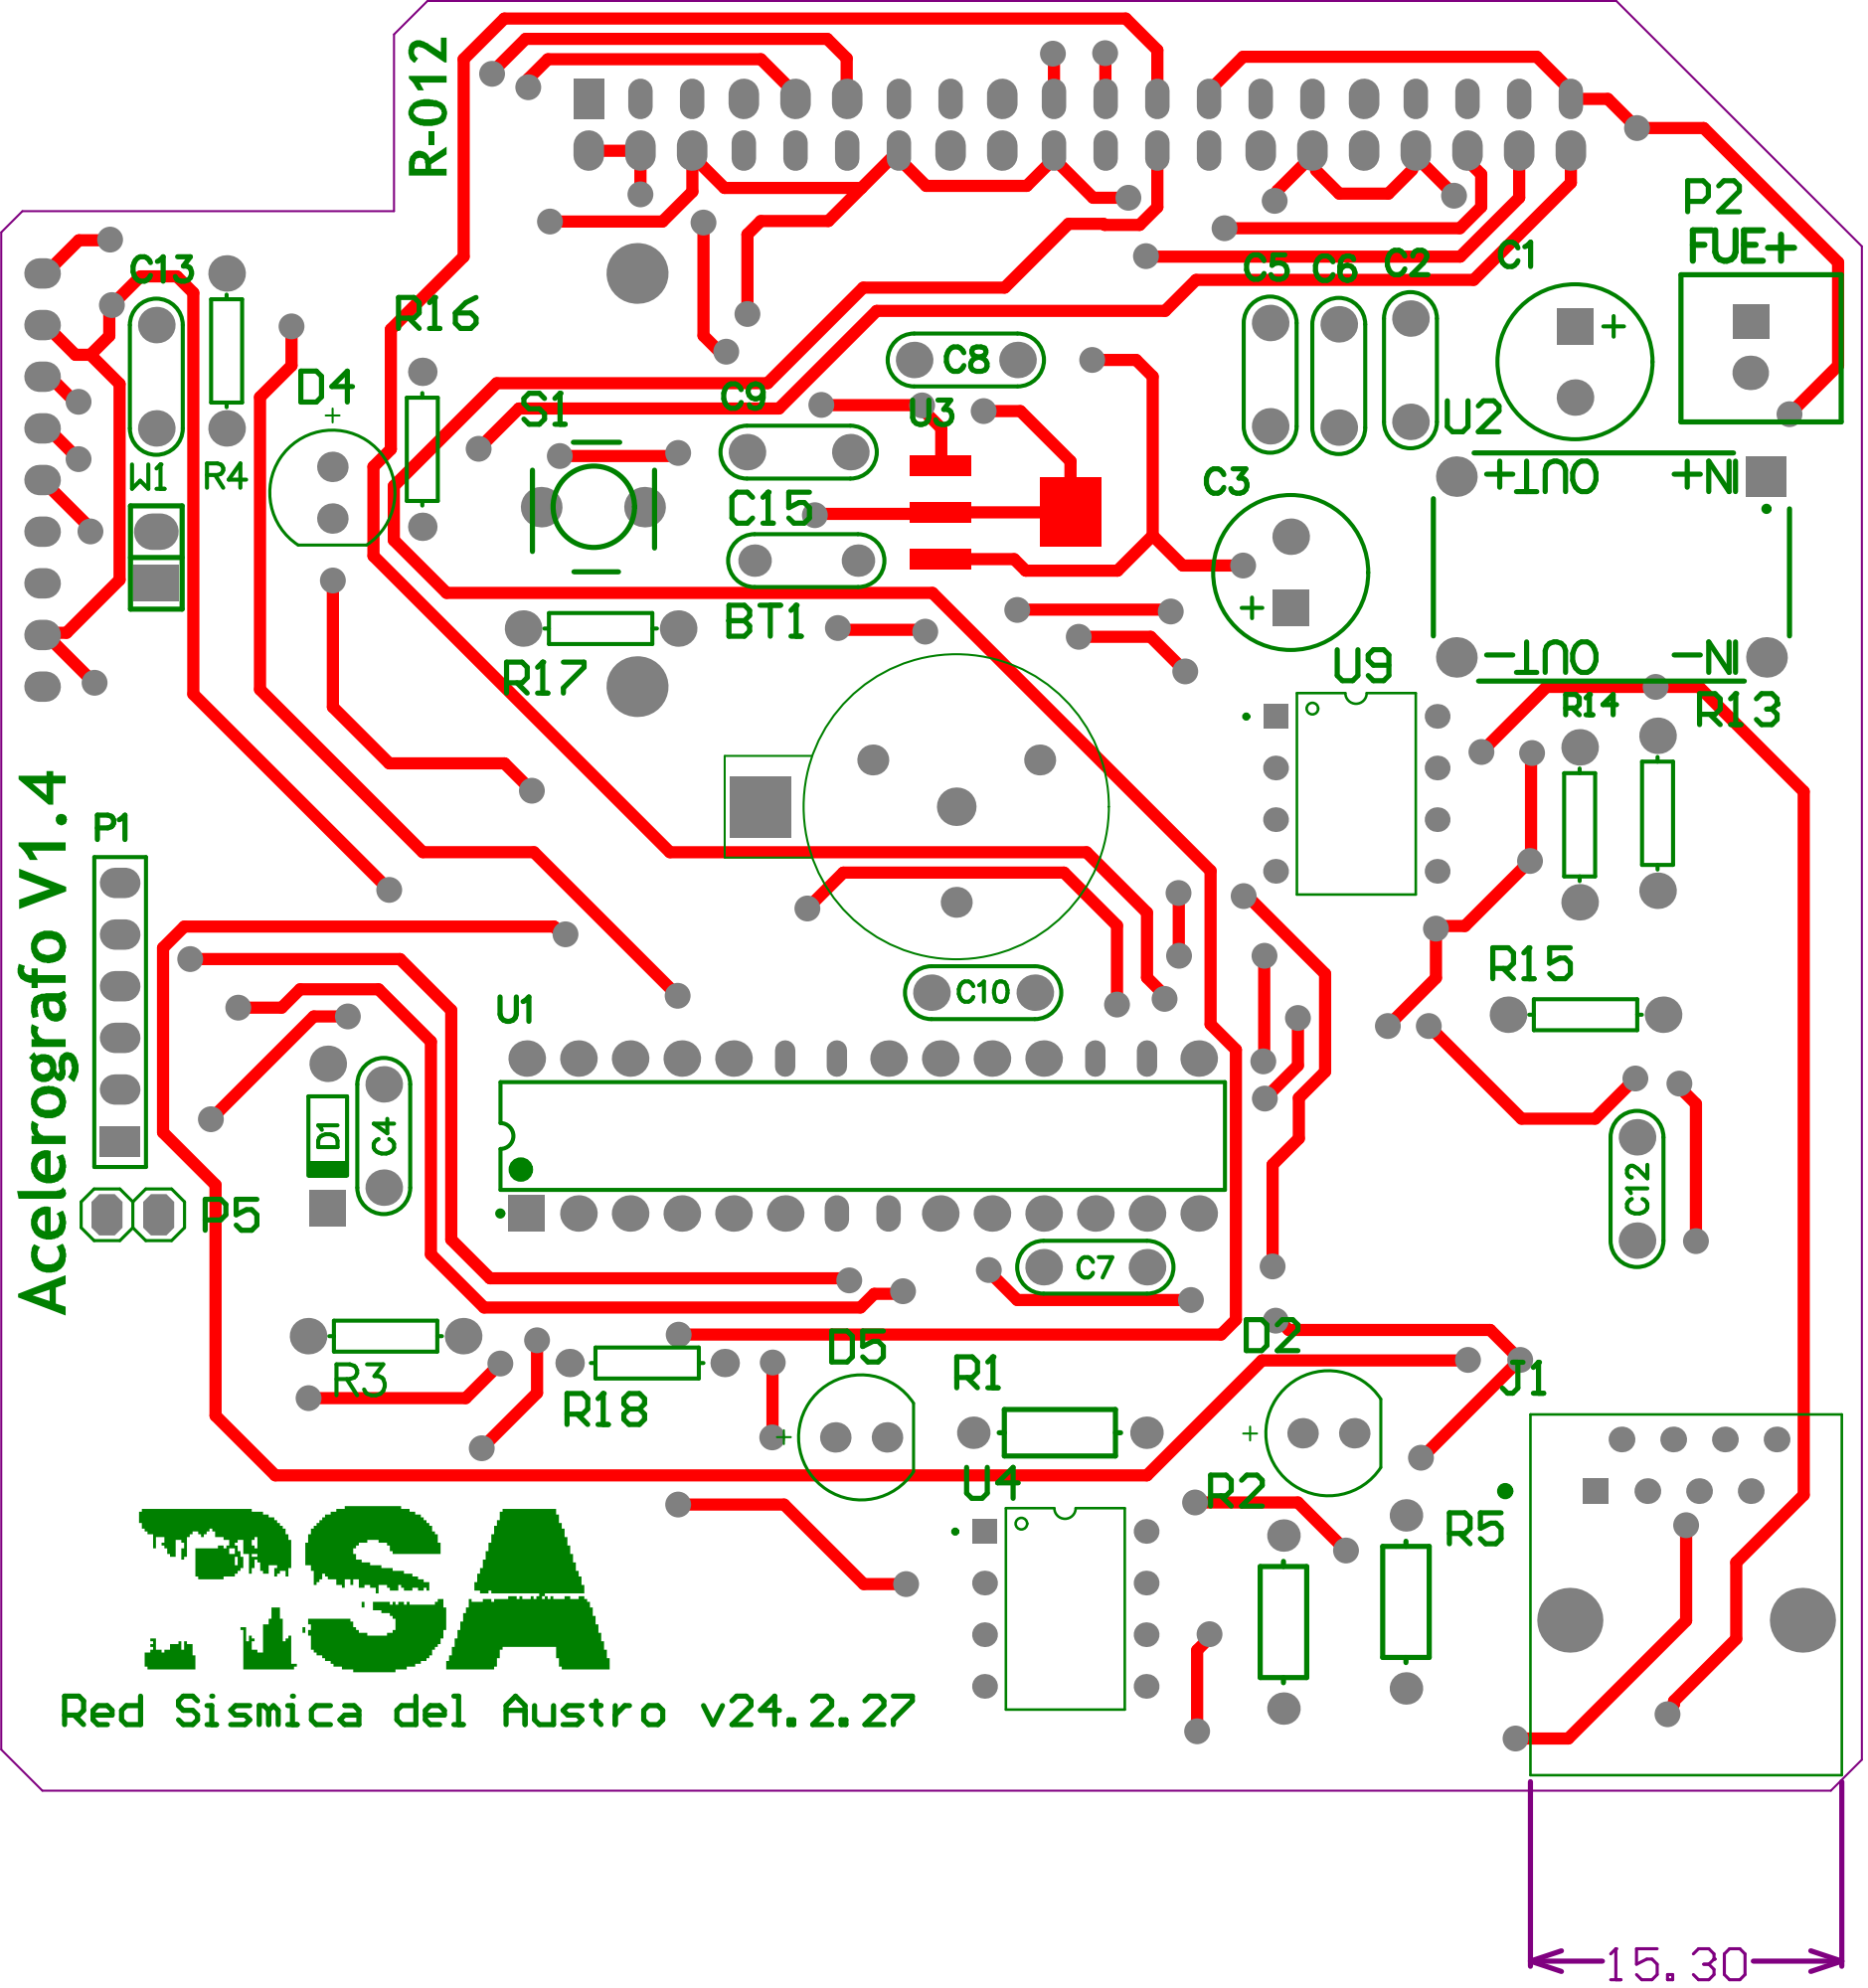
[picture p37: page 4]

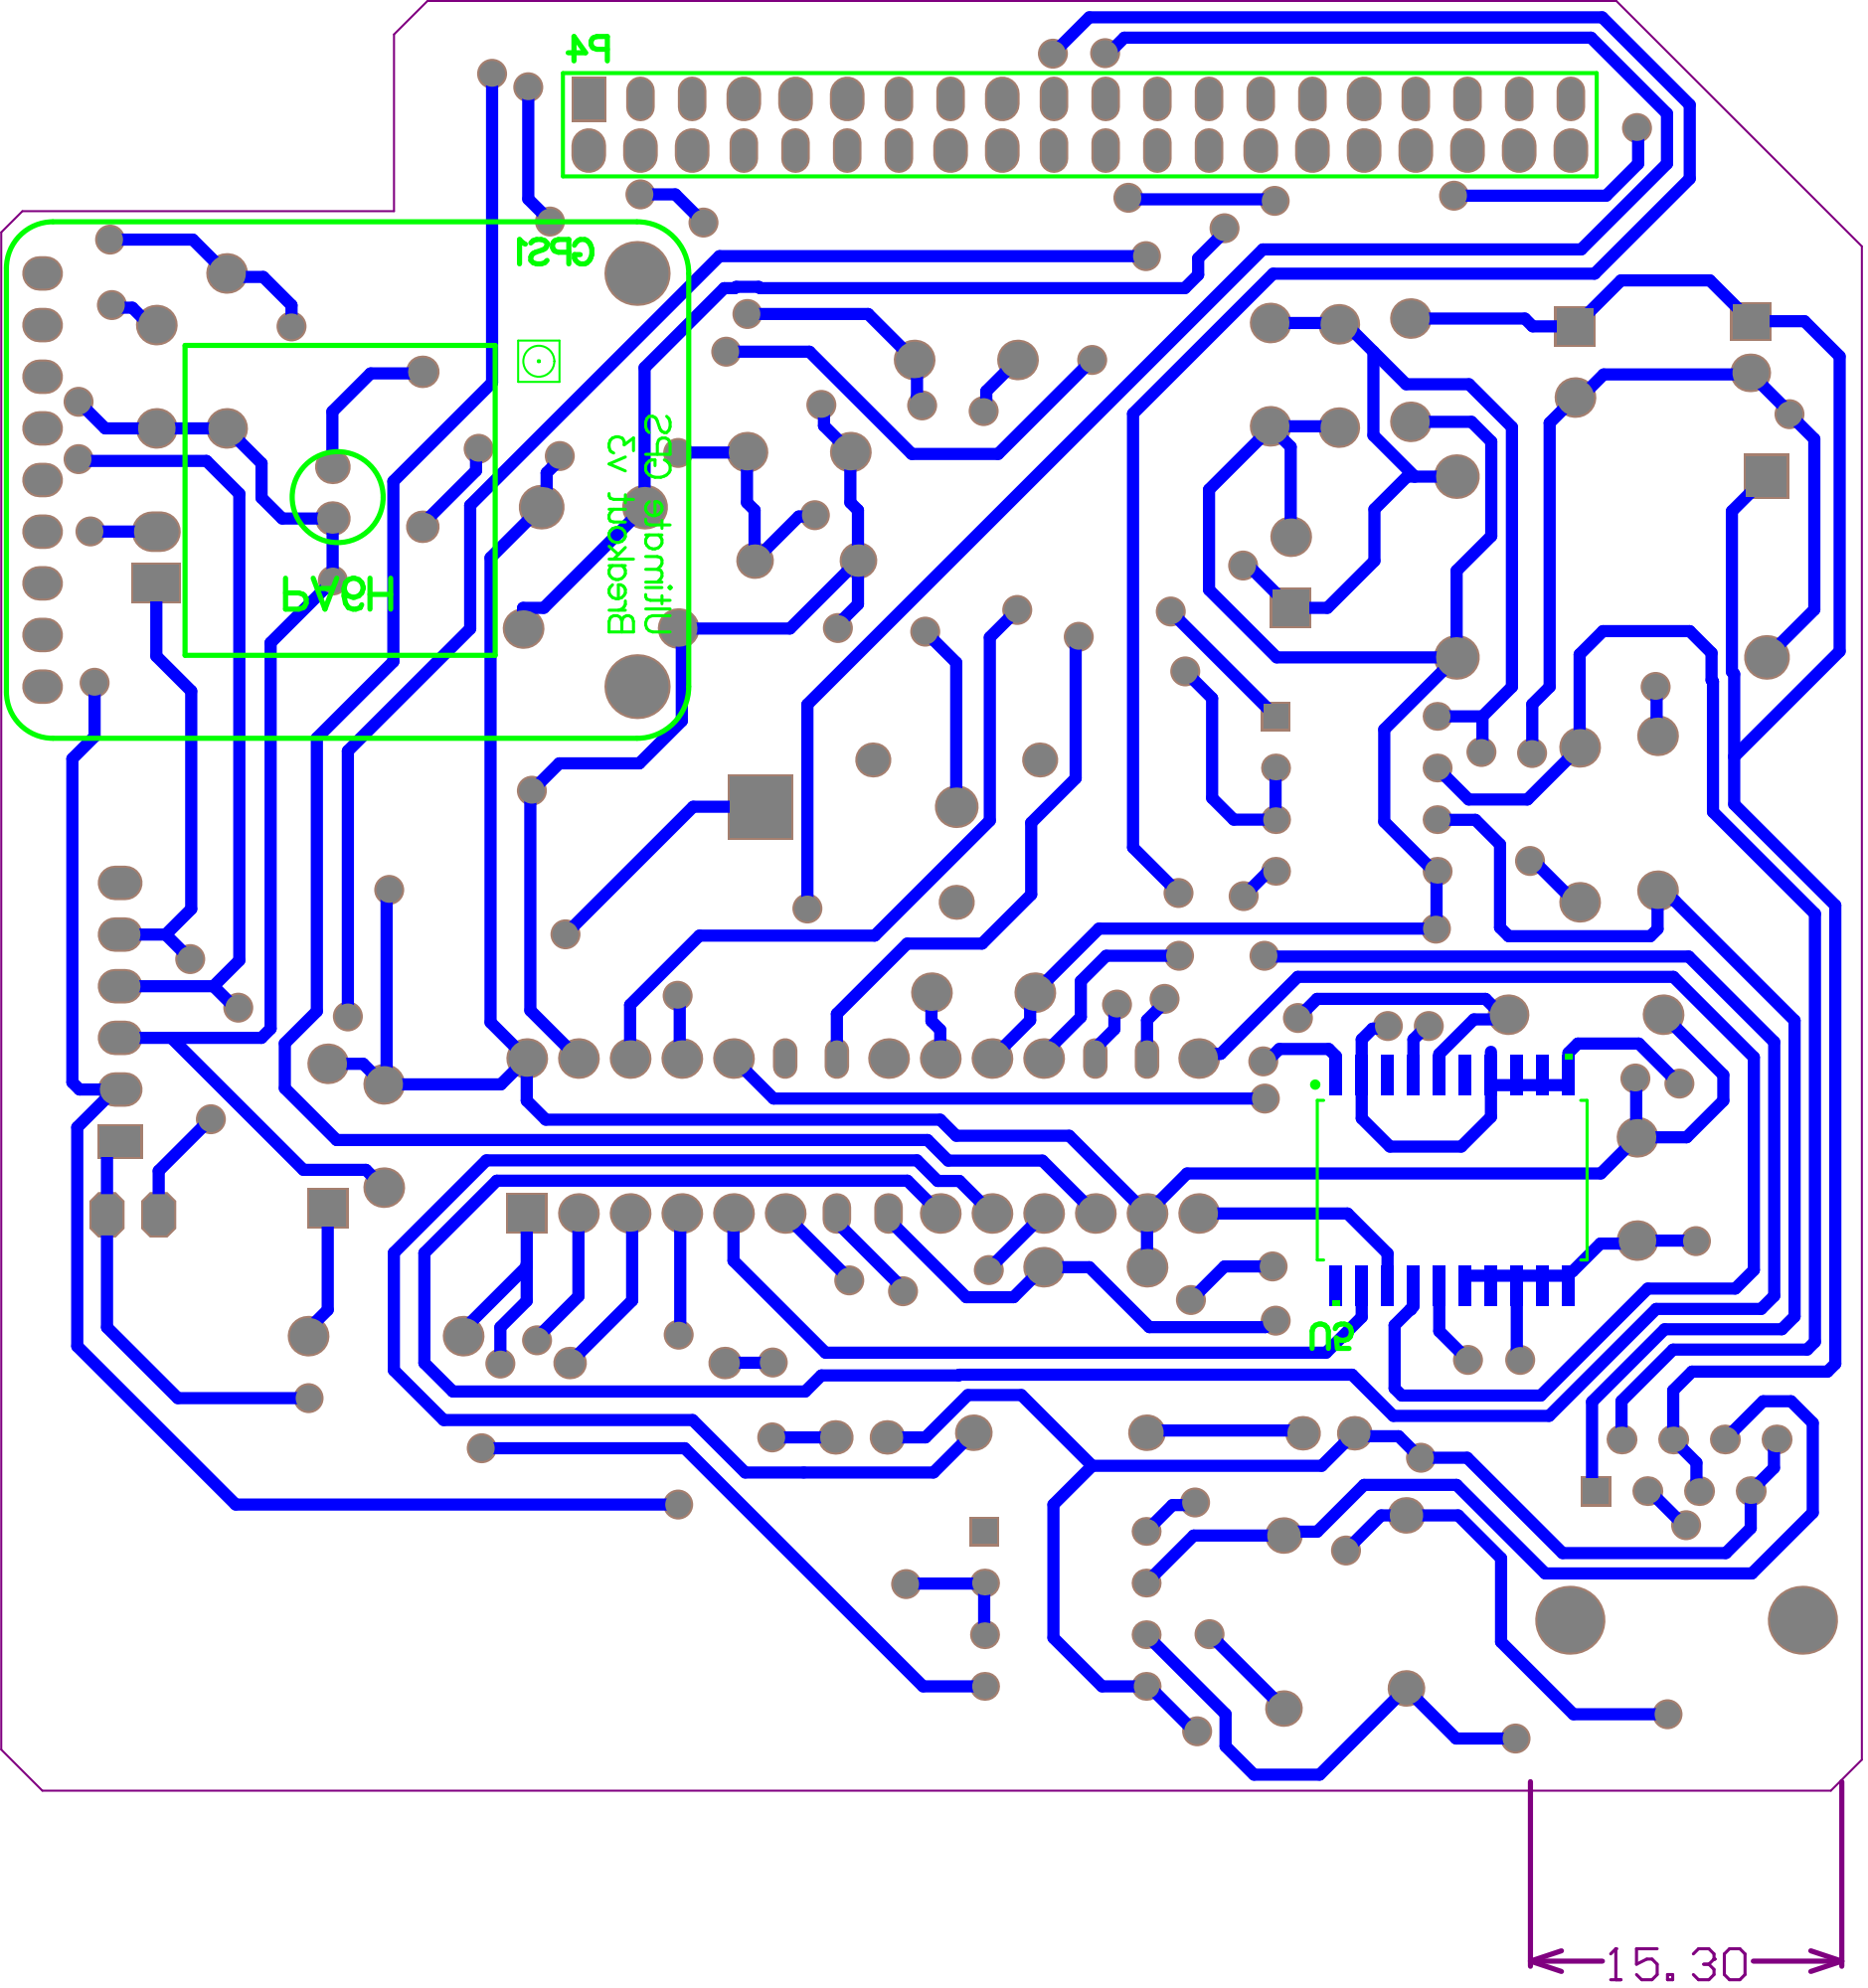
[picture p38: page 5]
