RSA-PPP/ppp-2024-02-shm-pcb-altium/docs/hardware/Job2_Nodo.PDF

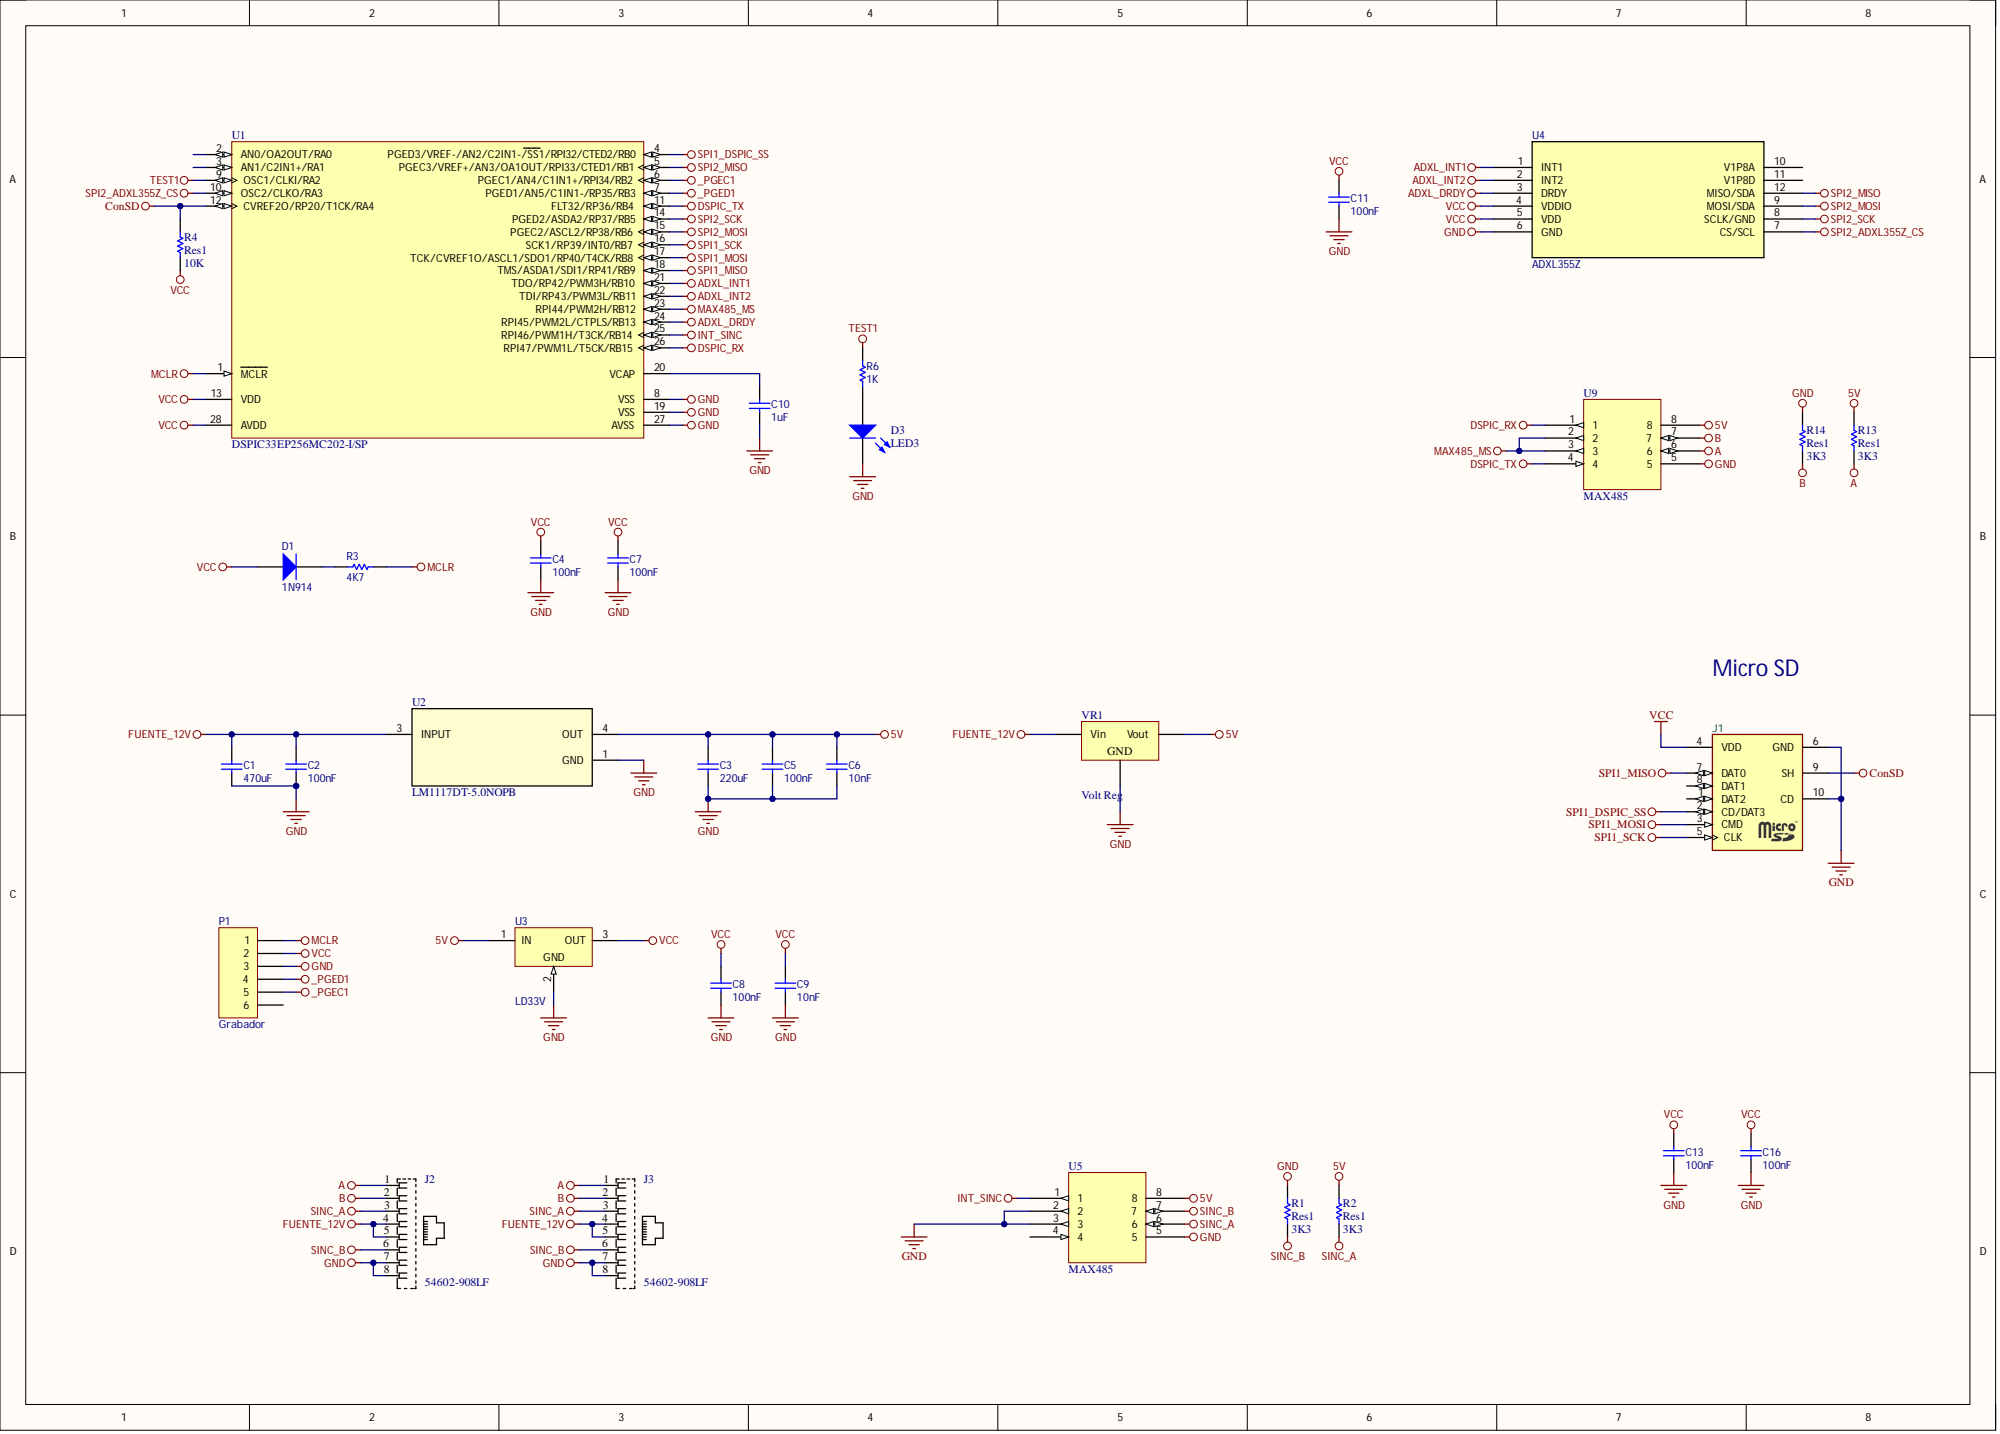
[picture p39: page 1]

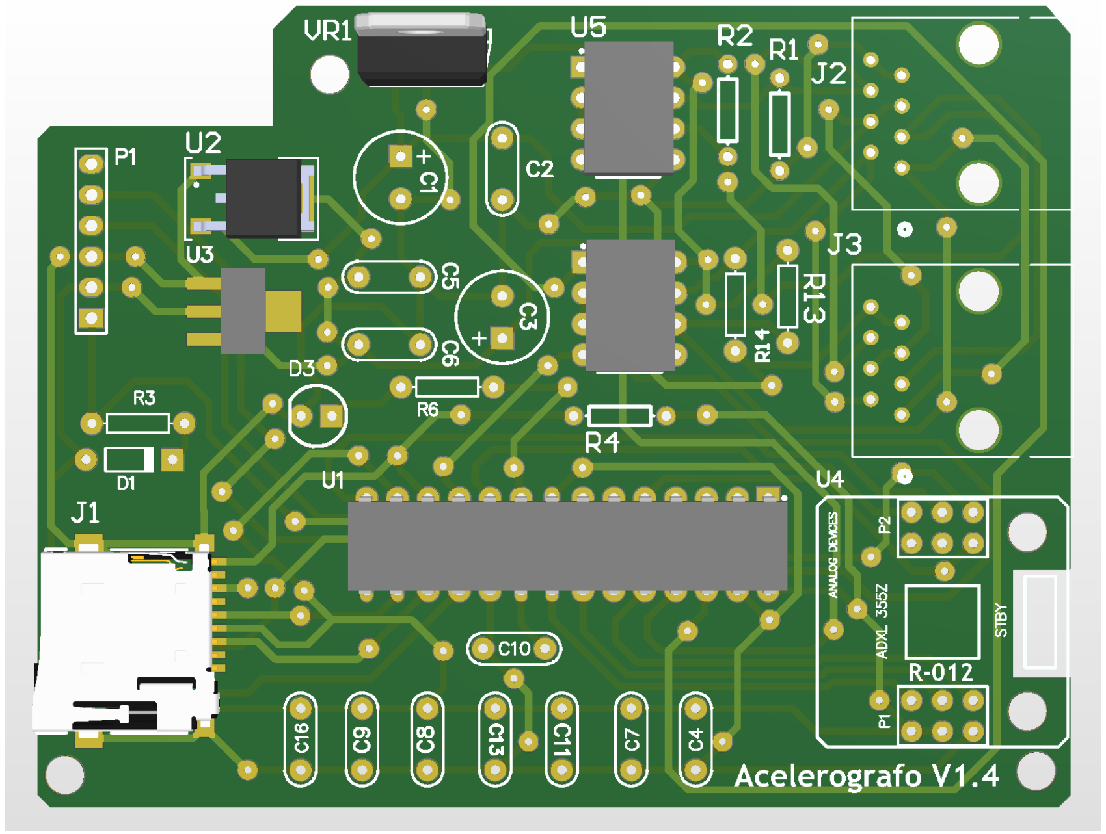
[picture p40: page 2]

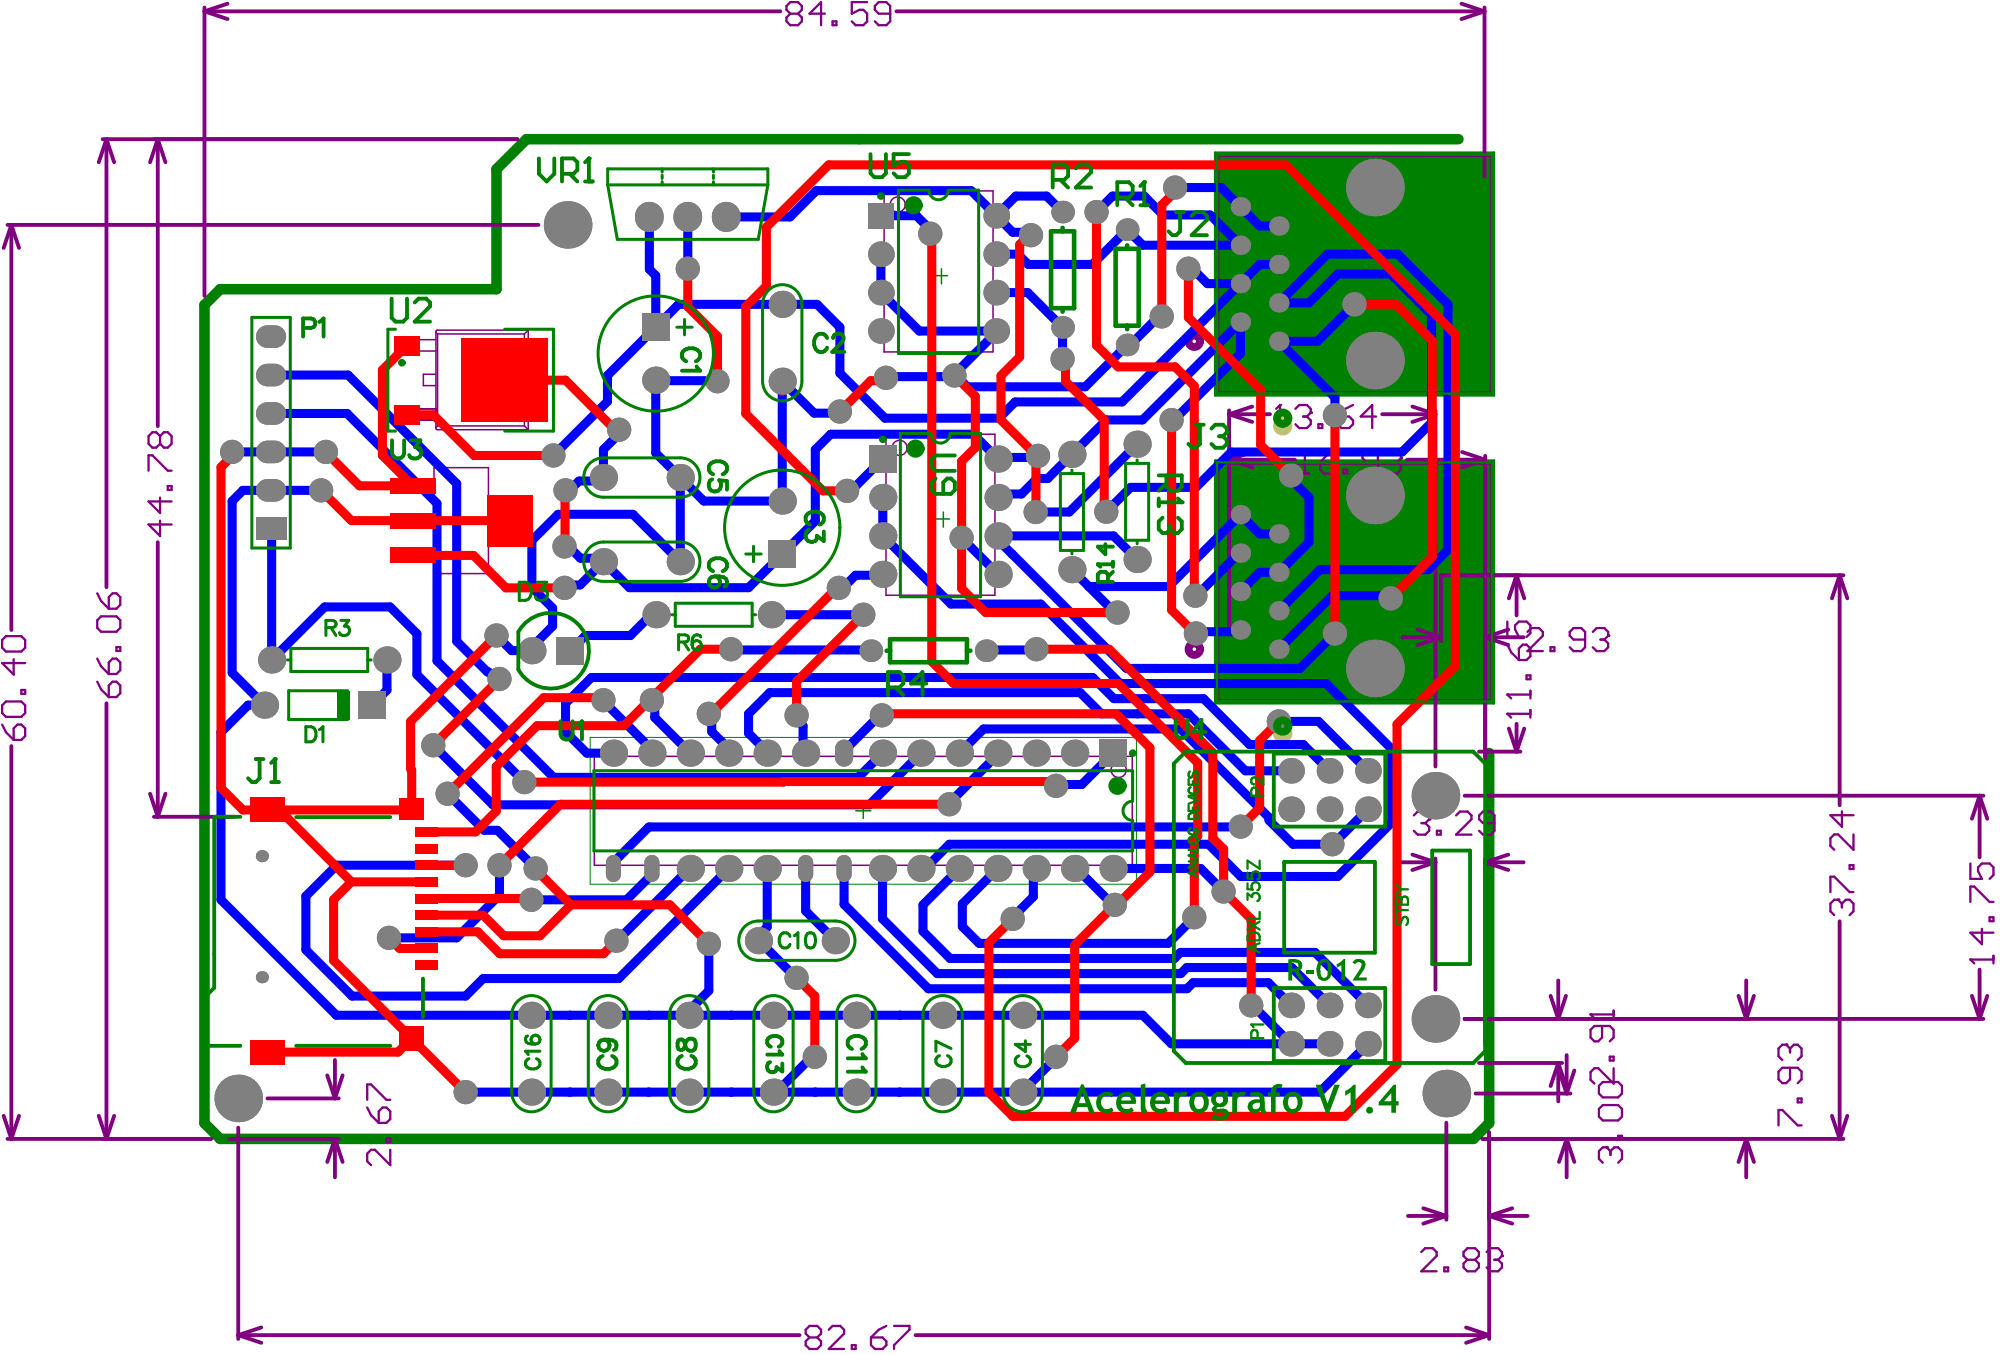
[picture p41: page 3]

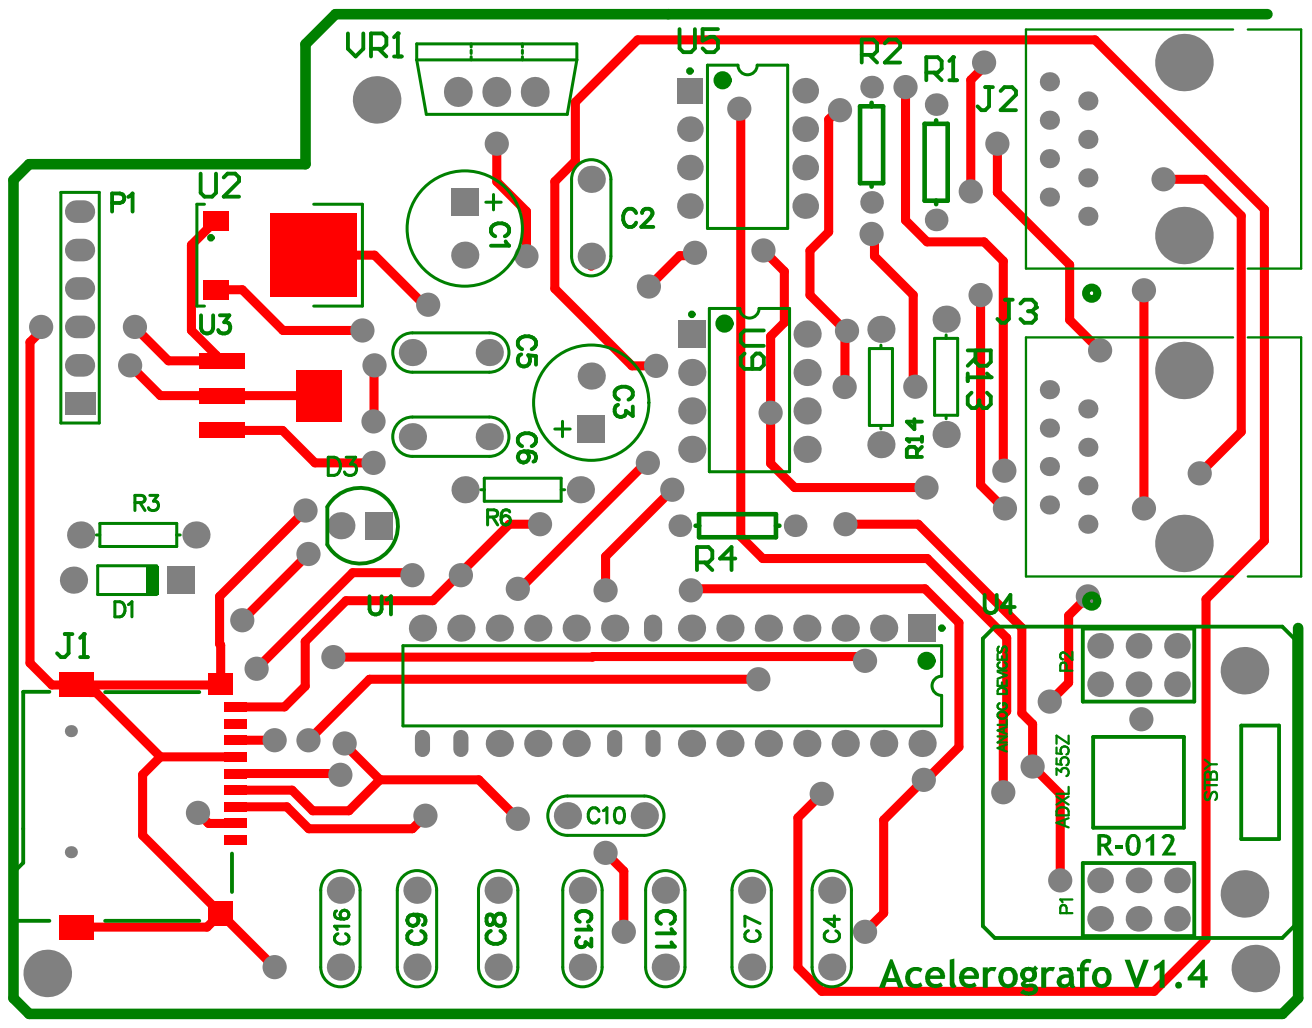
[picture p42: page 4]

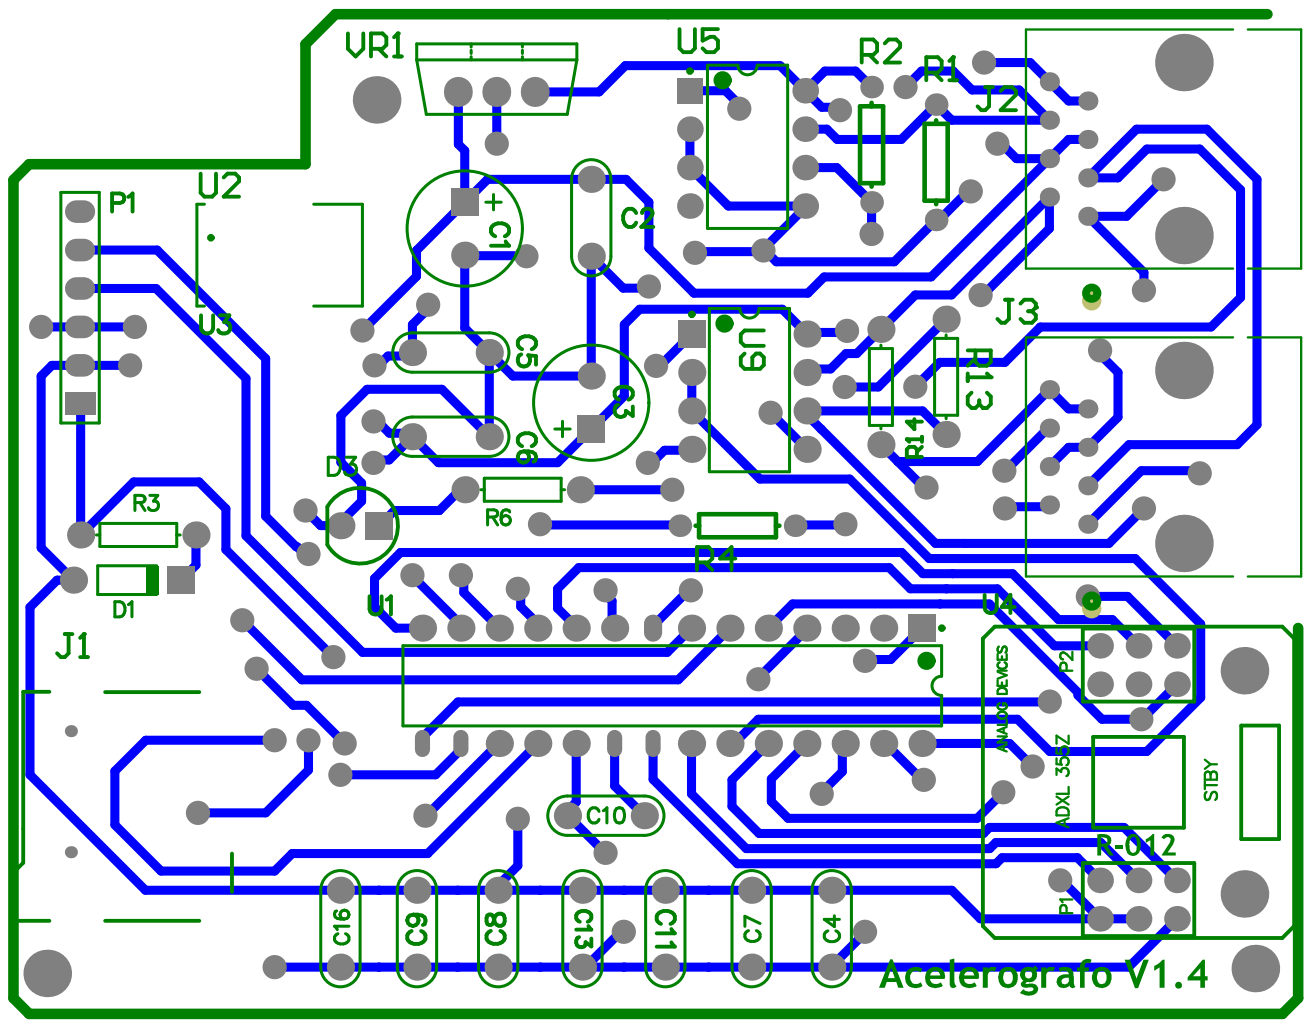
[picture p43: page 5]
