RSA-PPP/ppp-2024-02-shm-pcb-altium/(list of files, drawings)

Other design files:
altium/concentrador/imprimir.PcbDoc
altium/concentrador/PCB1.PcbDoc
altium/concentrador/PCB_Project.PrjPcb
altium/concentrador/PcbLib1.PcbLib
altium/concentrador/Schlib1.SchLib
altium/concentrador/Sheet1.SchDoc
altium/nodo/Esquema.SchDoc
altium/nodo/fotolitoTop.PcbDoc
altium/nodo/Librerias/acs714/altiumdesigner/ACS714.PcbLib
altium/nodo/Librerias/acs714/altiumdesigner/ACS714.SchLib
altium/nodo/Librerias/Conectores.PcbLib
altium/nodo/Librerias/digiKey/AltiumDesigner/54602-908LF.PcbLib
altium/nodo/Librerias/digiKey/AltiumDesigner/54602-908LF.SchLib
altium/nodo/Librerias/digiKey/LM1117DT_5_0_NOPB/AltiumDesigner/LM1117DT-5P0NOPB.PcbLib
altium/nodo/Librerias/digiKey/LM1117DT_5_0_NOPB/AltiumDesigner/LM1117DT-5P0NOPB.SchLib
altium/nodo/Librerias/DS3231STR/AltiumDesigner/DS3231STR.PcbLib
altium/nodo/Librerias/DS3231STR/AltiumDesigner/DS3231STR.SchLib
altium/nodo/Librerias/DS3234S/AltiumDesigner/DS3234S.PcbLib
altium/nodo/Librerias/DS3234S/AltiumDesigner/DS3234S.SchLib
altium/nodo/Librerias/HEF4071BP/AltiumDesigner/HEF4071BP/HEF4071BP.PcbLib
altium/nodo/Librerias/HEF4071BP/AltiumDesigner/HEF4071BP/HEF4071BP.SchLib
altium/nodo/Librerias/Libreria RSA/Capacitores.PcbLib
altium/nodo/Librerias/Libreria RSA/CircuitosIntegrados.PcbLib
altium/nodo/Librerias/Libreria RSA/Conectores.PcbLib
altium/nodo/Librerias/Libreria RSA/Conectores.SchLib
altium/nodo/Librerias/Libreria RSA/CristalesCuarzo.PcbLib
altium/nodo/Librerias/Libreria RSA/CristalesCuarzo.SchLib
altium/nodo/Librerias/Libreria RSA/Diodos.PcbLib
altium/nodo/Librerias/Libreria RSA/Displays.SchLib
altium/nodo/Librerias/Libreria RSA/Footprints.PcbLib
altium/nodo/Librerias/Libreria RSA/Integrados.SchLib
altium/nodo/Librerias/Libreria RSA/Interruptores.SchLib
altium/nodo/Librerias/Libreria RSA/LEDs.PcbLib
altium/nodo/Librerias/Libreria RSA/Logotipos.SchLib
altium/nodo/Librerias/Libreria RSA/Micelaneos.SchLib
altium/nodo/Librerias/Libreria RSA/Peinetas.PcbLib
altium/nodo/Librerias/Libreria RSA/project outputs for libreriarsa/LibreriaRSA/CircuitosIntegrados.PcbLib
altium/nodo/Librerias/Libreria RSA/project outputs for libreriarsa/LibreriaRSA/Conectores.PcbLib
altium/nodo/Librerias/Libreria RSA/project outputs for libreriarsa/LibreriaRSA/Conectores.SchLib
altium/nodo/Librerias/Libreria RSA/project outputs for libreriarsa/LibreriaRSA/CristalesCuarzo.PcbLib
altium/nodo/Librerias/Libreria RSA/project outputs for libreriarsa/LibreriaRSA/CristalesCuarzo.SchLib
altium/nodo/Librerias/Libreria RSA/project outputs for libreriarsa/LibreriaRSA/Displays.SchLib
altium/nodo/Librerias/Libreria RSA/project outputs for libreriarsa/LibreriaRSA/Footprints.PcbLib
altium/nodo/Librerias/Libreria RSA/project outputs for libreriarsa/LibreriaRSA/Integrados.SchLib
altium/nodo/Librerias/Libreria RSA/project outputs for libreriarsa/LibreriaRSA/Interruptores.SchLib
altium/nodo/Librerias/Libreria RSA/project outputs for libreriarsa/LibreriaRSA/Logotipos.SchLib
altium/nodo/Librerias/Libreria RSA/project outputs for libreriarsa/LibreriaRSA/Micelaneos.SchLib
altium/nodo/Librerias/Libreria RSA/project outputs for libreriarsa/LibreriaRSA/ReguladoresTransistores.PcbLib
altium/nodo/Librerias/Libreria RSA/project outputs for libreriarsa/LibreriaRSA/ReguladoresTransistores.SchLib
altium/nodo/Librerias/Libreria RSA/project outputs for libreriarsa/LibreriaRSA/Trimers.SchLib
altium/nodo/Librerias/Libreria RSA/ReguladoresTransistores.PcbLib
altium/nodo/Librerias/Libreria RSA/ReguladoresTransistores.SchLib
altium/nodo/Librerias/Libreria RSA/Resistencias.PcbLib
altium/nodo/Librerias/Libreria RSA/Transistores.SchLib
altium/nodo/Librerias/Libreria RSA/Trimers.SchLib
altium/nodo/Librerias/Libreria RSA/Trimmer.PcbLib
altium/nodo/Librerias/Microchip Footprints.PcbLib
altium/nodo/Librerias/Propia/Propia.PcbLib
altium/nodo/Librerias/Propia/Propia.SchLib
altium/nodo/Librerias/ST Logic Gate/ST Logic Gate.PcbLib
altium/nodo/Librerias/ST Logic Gate/ST Logic Gate.SchLib
altium/nodo/PCB.PcbDoc
altium/nodo/PcbLib1.PcbLib
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
